NicolasVMen/app_tcc/docs/produto/imagens_montagem/03-estrutura-3d-conceito-explodido.png

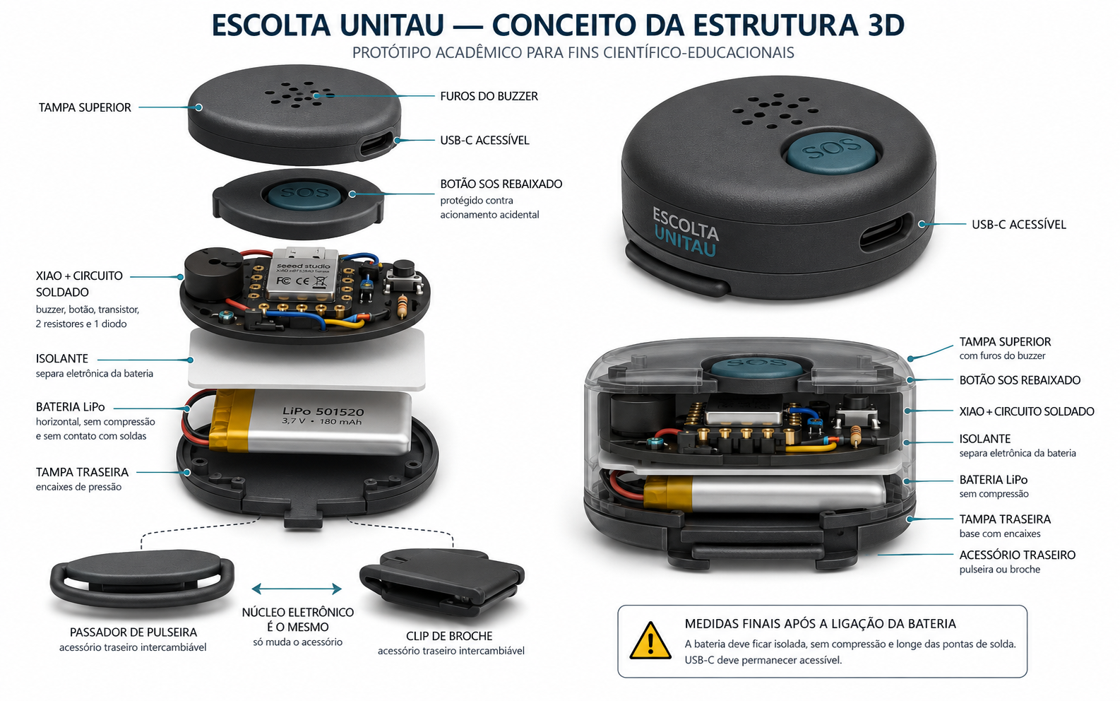
docs/produto/imagens_montagem/03-estrutura-3d-conceito-explodido.png
