NicolasVMen/app_tcc/docs/prototipo/fotos/WhatsApp Image 2026-09-24 at 19.42.54.jpeg

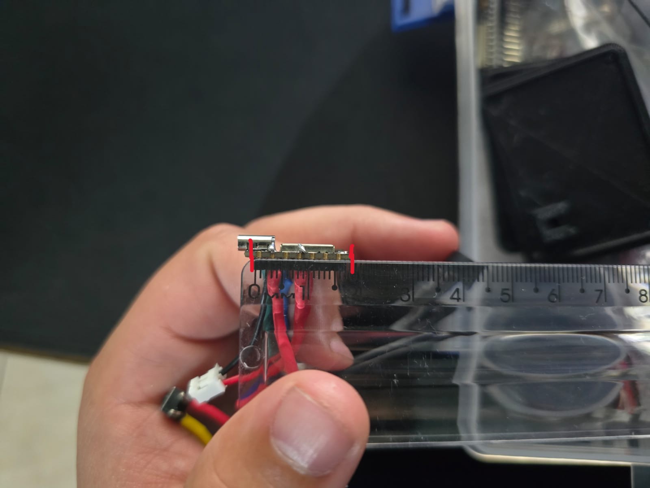
docs/prototipo/fotos/WhatsApp Image 2026-09-24 at 19.42.54.jpeg
