NicolasVMen/app_tcc/hardware/case_3d/documentacao/README_IMPRESSAO_V2_3.md

# ESCOLTA UNITAU — pacote de impressão V2.3

Revisão dimensional de 17/09/2026. Todas as fixações internas foram
padronizadas para abraçadeira de nylon T18R de 100 × 2,5 mm. Não alterar a
escala dos STL.

## Arquivos do conjunto

- `escolta_base_v2_3.stl`
- `escolta_tampa_v2_2.stl`
- `escolta_botao_reforcado_v2_2.stl`
- `escolta_trava_botao_reforcada_v2_2.stl`
- `escolta_protetor_bateria_v2_3.stl`

A tampa, o botão e a trava continuam na revisão V2.2 porque já foram
fisicamente testados. A revisão V2.3 altera somente a base e acrescenta o
protetor da bateria.

## Material de fixação

Usar quatro abraçadeiras comerciais T18R de 100 × 2,5 mm: XIAO, buzzer,
conector branco e bateria. Os túneis nominais medem 3,1 × 1,5 mm para receber
a cinta de 2,5 × 1,0 mm com folga de impressão.

Na bateria, a abraçadeira deve fechar sobre o protetor impresso. As duas pernas
do protetor ficam ao lado da bolsa e apoiadas no piso da caixa. Apertar somente
até retirar a folga; nunca esmagar ou dobrar a célula LiPo.

## Impressão

- Base e tampa: PLA ou PETG, bico 0,4 mm, camada 0,20 mm, três paredes e 20%
  de preenchimento.
- Protetor da bateria: PLA ou PETG, camada 0,20 mm, três paredes e 30% de
  preenchimento. A face larga já está orientada para a mesa.
- Botão e trava: PETG recomendado, camada 0,12 mm, quatro paredes e 100% de
  preenchimento.

As cinco malhas foram verificadas sem triângulos degenerados ou arestas
inválidas; cada arquivo possui um único corpo conectado e malha fechada.
