NicolasVMen/app_tcc/docs/cicted/banner/impressao/LEIA_ANTES_DE_IMPRIMIR.md

# Banner Escolta — arquivo para impressão

Enviar à gráfica: **Banner_Escolta_CICTED_EQUILIBRADO.pdf**.

Esta é a cópia mais recente, com legendas de fonte simplificadas para “acervo próprio” e “elaboração própria”. O conjunto das duas colunas foi deslocado 2,04 cm para cima, sem modificar o cabeçalho ou a identificação. Medindo os limites reais dos textos, o respiro entre identificação e conteúdo e entre conteúdo e borda inferior ficou em aproximadamente 5,18 cm nos dois lados. Foi preservado o alinhamento da fonte da Figura 3 com o fim das referências. As duas colunas têm a mesma largura e margens externas iguais; tabela e diagrama compartilham as bordas da coluna esquerda. O PDF foi gravado em estrutura clássica PDF 1.4, sem a árvore de marcação do Office, e sua página foi renderizada com sucesso em PDFium e PDF.js. A causa da visualização em branco no leitor do usuário não foi reproduzida; a nova estrutura é uma medida de compatibilidade, não uma causa confirmada.

- Tamanho nominal: **90 × 120 cm**, vertical, uma página.
- Imprimir a 100%, sem “ajustar à página”, sem converter o PDF em JPEG e sem otimização/compressão adicional.
- O PDF tem todas as fontes incorporadas. Os textos do trabalho continuam vetoriais.
- O **Banner_Escolta_CICTED_EQUILIBRADO.pptx** é uma cópia editável; não substitui o PDF final para a gráfica. Uma exportação comum do PowerPoint pode voltar a reduzir as imagens CAD.
- A **Banner_Escolta_CICTED_EQUILIBRADO_PREVIA.png** serve apenas para conferir o layout, não para impressão.
- Confirmar com a gráfica o perfil de cor adequado ao equipamento/material. Não aplicar conversão genérica de cor sem esse perfil.

## Melhorias e verificações

- Letras da tabela ampliadas de 22 para 24–26 pt; legendas/fontes/referências ampliadas para pelo menos 24 pt, com contraste mais escuro.
- Conferência das caixas de texto no PowerPoint: nenhum texto excedendo a altura disponível.
- Vistas CAD geradas novamente a partir do projeto local: 4.000 × 3.000 pixels por imagem, aproximadamente 1.010 ppi na dimensão diagramada.
- Cabeçalho vetorizado a partir do raster do template. As duas legendas pequenas dos logotipos foram recompostas como texto, mantendo suas palavras. A vetorização não recupera os contornos de um original vetorial oficial inexistente nesta pasta.
- Recursos integrais reinseridos no PDF após a exportação: PNG sem perdas; JPEG com seus bytes originais, sem nova recodificação. Posições e dimensões preservadas.
- A verificação automatizada compara as imagens do PDF com as do PPTX e confirma a preservação exata dos pixels/bytes.
- Versões anteriores preservadas.

## Limites reais das imagens disponíveis

As três capturas do aplicativo têm 816–821 × 1.599–1.600 pixels: aproximadamente **182–183 ppi** no tamanho diagramado. As fotografias presentes na versão anterior têm aproximadamente **242–261 ppi**. Esses recursos foram preservados na resolução integral, sem nova edição generativa nesta revisão.

Aumentar artificialmente a quantidade de pixels não recupera detalhes verdadeiros. Para elevar a definição efetiva dessas capturas/fotografias, são necessários novos arquivos originais de maior resolução e sem compressão de mensageiros. Além disso, letras pequenas dentro das telas do aplicativo continuam pequenas fisicamente no banner; resolução, por si só, não resolve esse limite de leitura.

Antes de autorizar a tiragem, vale pedir à gráfica uma prova em escala 1:1 de um trecho de texto e de uma captura do app. Isso verifica o efeito do material, tinta, equipamento e iluminação, que não pode ser certificado somente pelo arquivo digital.
