NicolasVMen/app_tcc/docs/cicted/banner/Banner_Escolta_UNITAU_CICTED_2026_CONSIDERACOES_REVISADAS.pptx

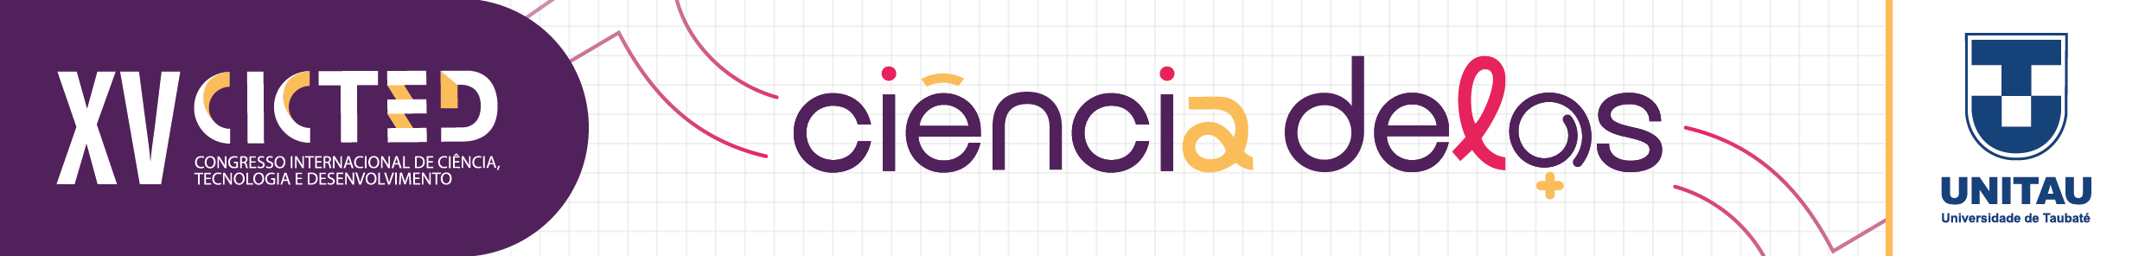
[picture p3: figure]

ENIC GRADUAÇÃO — APRESENTAÇÃO EM PÔSTER

Nº DO TRABALHO: 1782760

Autores: Nicolas Venciguerra Men; Rafael Gonçalves Dedini

Orientador: Prof. Dr. Luis Fernando de Almeida

Figura 1 — estados do aplicativo durante o afastamento

ESCOLTA UNITAU: PROTÓTIPO VESTÍVEL PARA MONITORAMENTO DE PROXIMIDADE INFANTIL POR BLUETOOTH LOW ENERGY

Introdução

Em locais movimentados, o afastamento de uma criança pode não ser percebido de imediato. O Escolta UNITAU integra dispositivo vestível e aplicativo Android para acompanhar condições de proximidade por BLE, sinalizar degradação ou perda do enlace e oferecer um botão físico de emergência. Objetivo: avaliar essa prova de conceito integrada.

Protegido

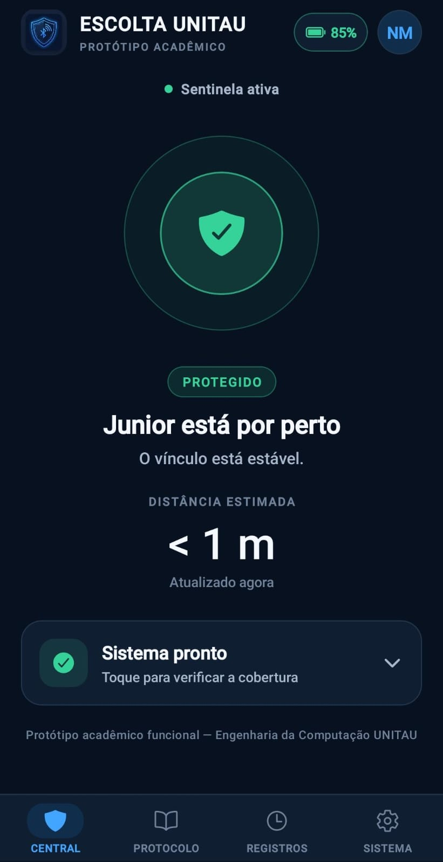
[picture p4: figure]

Alcance Reduzido

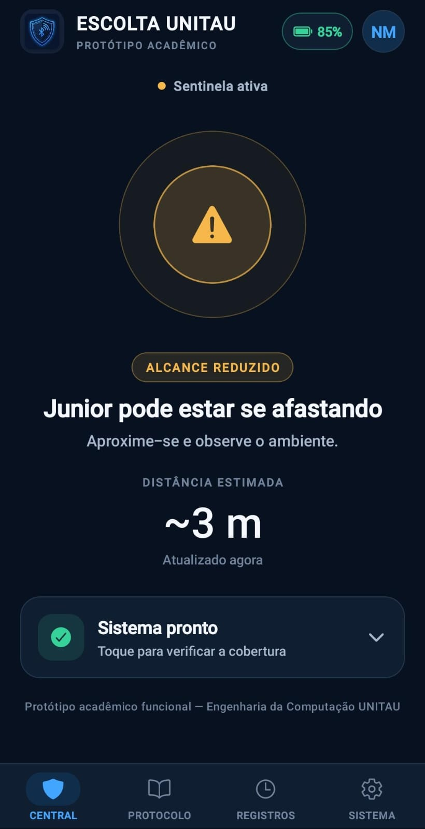
[picture p5: figure]

Emergência

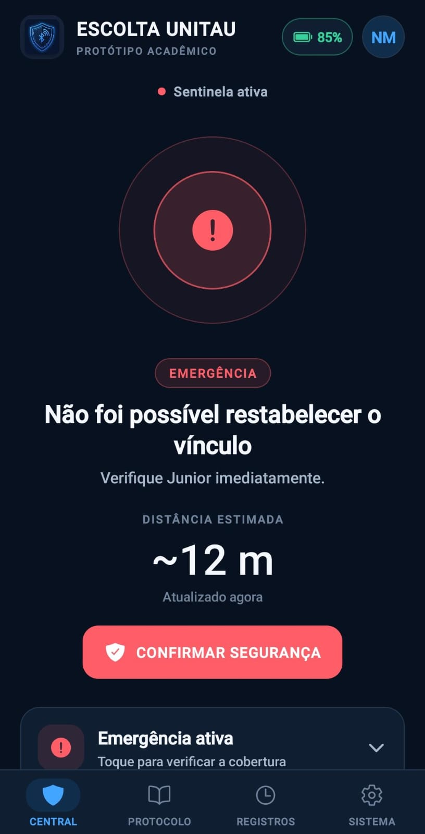
[picture p6: figure]

Método

Pesquisa aplicada e experimental. Vestível com XIAO nRF52840 Sense, firmware C++/Arduino, buzzer, botão e LiPo 180 mAh; app Android em React Native/Expo com serviço em primeiro plano. RSSI usado como indicador experimental de proximidade. Ensaios iterativos iniciais em Samsung Galaxy S24 Ultra.

Resultados

Fonte: capturas reais dos autores (2026). Metros exibidos: estimativas por RSSI.

Figura 2 — projeto CAD e protótipo físico

OpenSCAD · perspectiva

OpenSCAD · vista superior

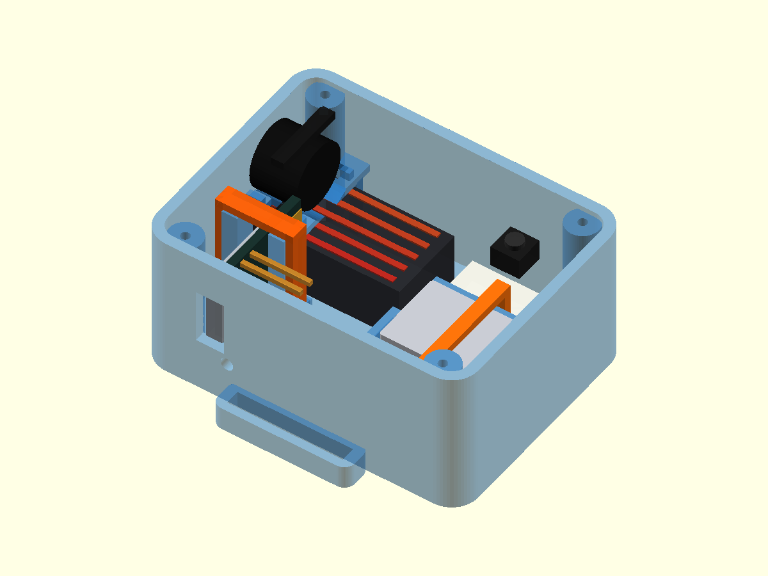
[picture p7: figure]

Caixa aberta

Caixa fechada

CENÁRIO

Vínculo BLE

COMO FOI VERIFICADO

Conexão, perda do enlace e tentativas de reconexão.

RESULTADO OBSERVADO

A perda acionou alerta no telefone; o sistema tentou reconectar.

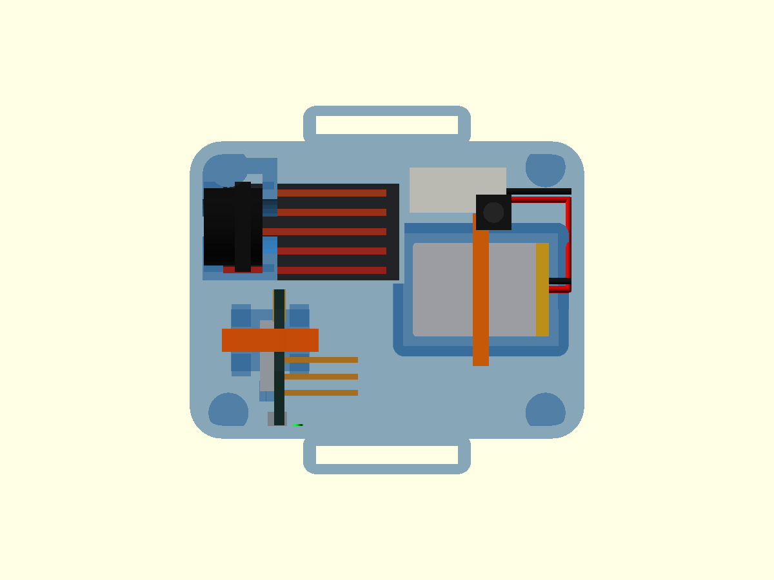
[picture p8: figure]
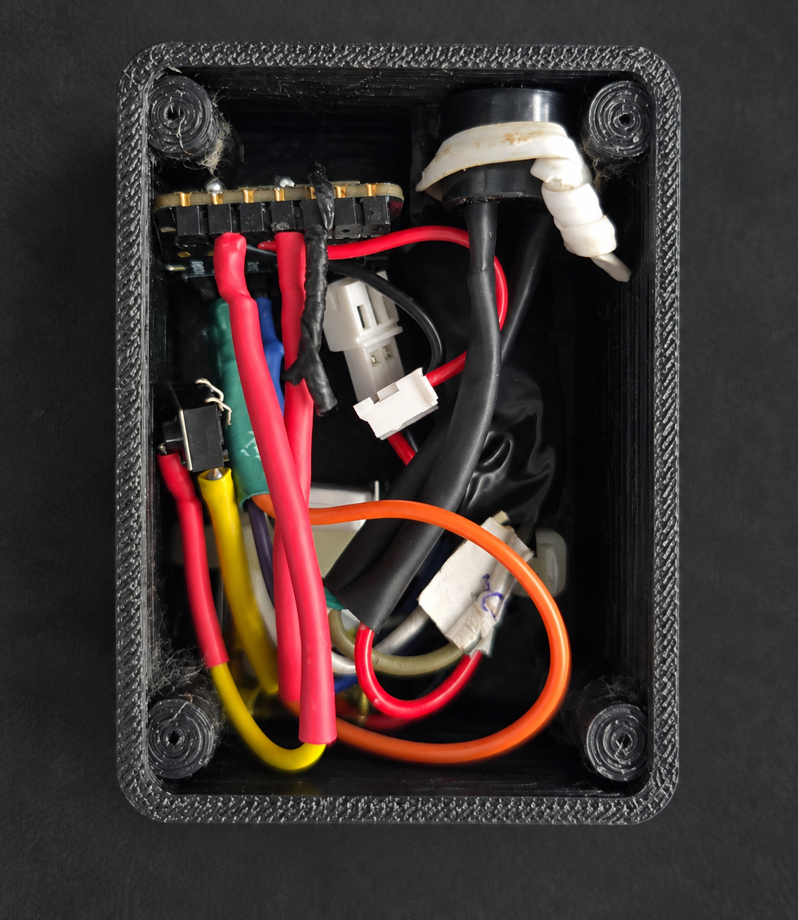
[picture p9: figure]
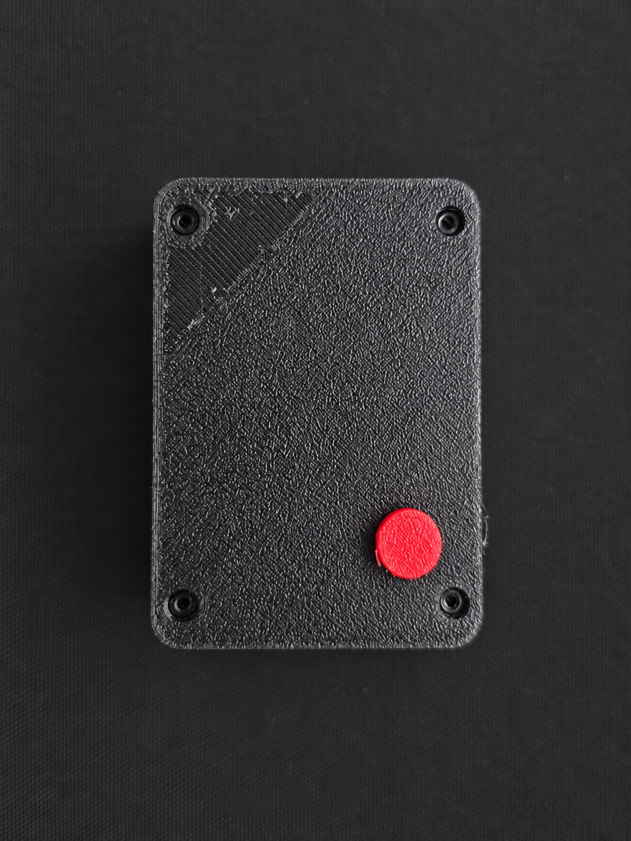
[picture p10: figure]

Segundo plano

Botão físico

Aplicativo

Tela bloqueada e serviço Android em primeiro plano.

Acionamento de emergência no vestível conectado.

Navegação, estados, registros e confirmação de segurança.

Após correções do serviço, a monitoração persistiu.

Resposta sonora no dispositivo e no telefone.

Estados protegido, alcance reduzido e emergência registrados.

Fonte: modelo CAD e fotografias dos autores (2026).

Considerações finais

A integração entre o vestível e o aplicativo demonstrou viabilidade técnica nas condições ensaiadas. Após as correções no serviço Android, a monitoração persistiu no Galaxy S24 Ultra, modelo usado na validação inicial. A perda do enlace BLE acionou o alerta de desconexão, enquanto o botão físico permitiu disparar o alerta manual.
Em um ciclo de monitoração contínua, a placa operou por 11 h 10 entre 90% e 5% de carga estimada, com as saídas automáticas de alerta bloqueadas. Trata-se de um resultado preliminar: o tempo de uso pode mudar com reconexões, acionamentos sonoros e outras condições de operação.
O RSSI permitiu observar mudanças na intensidade do sinal, mas variou com obstáculos, orientação e ambiente. Por isso, os valores indicados pelo aplicativo não devem ser interpretados como medição precisa de distância. Os testes confirmam o funcionamento integrado do protótipo, mas ainda não permitem generalizar o desempenho para diferentes celulares e cenários de uso.

Síntese dos cenários documentados para o conjunto vestível + aplicativo.

Gráfico 1 — autonomia preliminar

100%

Carga estimada da bateria (%)

90%

4,09 V

75%

50%

25%

0%

INÍCIO

BATERIA BAIXA

10%

3,58 V

FIM DO ENSAIO

5%

3,54 V

Referências

BLUETOOTH SIG. The Bluetooth Low Energy Primer. 2022.
FARAGHER, R.; HARLE, R. Location Fingerprinting With Bluetooth Low Energy Beacons. IEEE JSAC, 33(11), 2015.
SAKPHROM, S. et al. A Simplified and High Accuracy Algorithm of RSSI-Based Localization Zoning for Children Tracking In-Out the School Buses Using Bluetooth Low Energy Beacon. Informatics, 8(4):65, 2021.

LiPo 180 mAh · um ciclo · monitoramento BLE contínuo · saídas automáticas de alerta bloqueadas.

Fonte: ensaio de bateria dos autores, 08–09/09/2026.

0 h

10 h 05

11 h 10
