NicolasVMen/app_tcc/docs/README.md

# Documentação

- `cicted/`: arquivos identificados, anônimos, revisões e versão final do evento.
- `produto/`: especificação funcional, fluxos e diagramas de montagem.
- `prototipo/`: fotografias originais usadas nas medições do hardware.
- `tcc/`: capítulos, projeto de pesquisa e modelos acadêmicos.
- `testes/`: relatórios de celular, autonomia e demais ensaios.
- `auditoria/`: mapa da arquitetura, catálogo por arquivo, evidências e pendências.

Fechamento acadêmico: [plano e critérios de atualização de 04/11/2026](tcc/FECHAMENTO_TCC_2026-11-04.md).
Próximo ensaio: [protocolo de autonomia com registro proposto](testes/PROTOCOLO_AUTONOMIA_USO_2026-11-04.md).
Distribuição: [oficial Android 1.0.1, aceite de 17/10 e atualização do botão em 04/11](auditoria/PREPARACAO_OFICIAL_VALIDADA_2026-10-17.md).
Referência histórica: [auditoria de 07/10/2026](auditoria/RELATORIO_2026-10-07.md).
Implementações posteriores: [correções de 09/10/2026](auditoria/CORRECOES_2026-10-09.md).
CICTED e TCC são entregas diferentes; manter seus documentos separados.

Arquivos intermediários permanecem em suas respectivas subpastas para manter
o histórico acadêmico separado do código do aplicativo.

Capturas do console autenticado, credenciais, dependências locais e backups
permanecem somente no computador; não integram o versionamento público.
