NicolasVMen/app_tcc/docs/tcc/README.md

# Texto acadêmico — Escolta UNITAU

## Revisão atual de 04/11/2026

- `TCC_Escolta_UNITAU_ATUALIZADO_2026-11-04.docx`: cópia editável, com desenvolvimento,
  resultados e conclusão preenchidos e atualização técnica dos capítulos iniciais.
- `TCC_Escolta_UNITAU_ATUALIZADO_2026-11-04.pdf`: exportação do mesmo Word, 41 páginas.
- `FECHAMENTO_TCC_2026-11-04.md`: critérios de evidência, pendências e confirmação
  de envio ao Drive, incluindo links e hashes locais.
- `REVISAO_2026-11-04_CAPITULOS_4_A_6.md`: fonte textual dos capítulos acrescentados.
- `VERIFICACAO_REVISAO_2026-11-04.json`: integridade do original e dados do gráfico.
- `VERIFICACAO_PDF_2026-11-04.json`: conferência estrutural/textual das páginas.

A revisão é fiel às fontes de implementação e aos resultados identificados,
mas **ainda precisa de revisão dos autores e do orientador**. Não é declaração
de homologação, patenteabilidade ou conformidade normativa integral.
Autonomia atual e bateria baixa real permanecem sem novo ensaio. A proposta
de coletor não foi implementada e não é apresentada como resultado obtido.

Word no Drive: https://docs.google.com/document/d/1DhnyRvAgA25Ioz3kZwKFdNv8MnQj-EA_/edit

PDF no Drive: https://drive.google.com/file/d/1Dv2qfMFWDSk-kZCphoBeKt73M8d9ED3b/view

## Histórico e preservação

Arquivos `TG_Escolta_UNITAU_ate_Capitulo_4.*`, capítulo introdutório,
projeto de pesquisa e template são fontes históricas; não representam a
revisão atual. Permanecem preservados. A cópia original do Word do Drive
foi salva em `backups/tcc/2026-11-04/` e também duplicada na pasta do Drive
antes da atualização, sem alterar os arquivos do 9º semestre.

Ferramentas locais de reprodução: `tools/atualizar_tcc_2026_11_04.py`,
`tools/renderizar_tcc_word_2026_11_04.ps1` e `tools/conferir_pdf_tcc_2026_11_04.mjs`.
O gerador depende da fonte original identificada; não o executar sobre uma
revisão manual posterior sem antes comparar as alterações. O script Word
gera artefatos; não envia arquivos ao Drive ou GitHub automaticamente.
