NicolasVMen/app_tcc/docs/cicted/PENDENCIAS_PARA_SUBMISSAO.md

# Situação da submissão ao XV CICTED 2026

O resumo foi revisado pelo orientador e preparado nas versões identificada e não identificada exigidas pela plataforma Even3.

Antes de gerar a versão final, confirmar:

- [x] orientador: Luis Fernando de Almeida;
- [x] e-mail de Rafael: `rafael.gdedini@unitau.br`;
- [x] e-mail do orientador: `luis.almeida@unitau.br`;
- [x] e-mail institucional de Nicolas: `nicolas.vmen@unitau.br`;
- [x] orientador incluído como coautor;
- [x] categoria: `ENIC Graduação — Apresentação em Pôster — Resumo`;
- [x] área temática: `EXATAS`;
- [x] ODS 3 – Saúde e Bem-Estar;
- [x] ODS 9 – Indústria, Inovação e Infraestrutura;
- [x] declaração de uso supervisionado de IA generativa incluída no resumo;
- [x] revisão do orientador recebida e incorporada;
- [x] ORCID de Nicolas conectado à Even3;
- [x] arquivo identificado gerado;
- [x] arquivo não identificado e sem metadados pessoais gerado;
- [ ] concluir e confirmar a submissão na Even3;
- [ ] após a aprovação, obter o modelo e as dimensões oficiais do pôster de 2026;
- [ ] preparar o pôster e a apresentação curta do protótipo.

Prazo informado no material fornecido: **14 de setembro de 2026**.

A versão de submissão deve permanecer em formato editável `.docx`, sem citações, notas de rodapé, tabelas, figuras ou referências bibliográficas.
