NicolasVMen/app_tcc/CICTED/Banner_Escolta_CICTED_EQUILIBRADO.pptx

ENIC GRADUAÇÃO — APRESENTAÇÃO EM PÔSTER

Nº DO TRABALHO: 1782760

Autores: Nicolas Venciguerra Men; Rafael Gonçalves Dedini

Orientador: Prof. Dr. Luis Fernando de Almeida

Figura 1 — estados do aplicativo durante o afastamento

ESCOLTA UNITAU: PROTÓTIPO VESTÍVEL PARA MONITORAMENTO DE PROXIMIDADE INFANTIL POR BLUETOOTH LOW ENERGY

Introdução

Protegido


Alcance Reduzido


Emergência


Em locais movimentados, o afastamento de uma criança pode não ser percebido de imediato. (Colocar citação, estatísticas, se tiver) O Escolta UNITAU integra dispositivo vestível e aplicativo Android para acompanhar condições de proximidade por Bluetooth Low Energy (BLE) – Termo em inglês em itálico, sinalizar degradação ou perda do enlace e oferecer um botão físico de emergência.
Colocar objetivo do trabalho, antes do escolta Unitau, objetivo antes do “produto”
Trocar de posição figura 1 com a figura 3, para fazer sentido, figura 3(Resultado), figura 1 (Arquitetura)

Método

Trata-se de uma pesquisa aplicada e experimental. Vestível com XIAO nRF52840 Sense, firmware C++/Arduino, buzzer, botão e LiPo 180 mAh; app Android em React Native/Expo com serviço em primeiro plano. RSSI usado como indicador experimental de proximidade. Ensaios iterativos preliminares em Samsung Galaxy S24 Ultra.
Como foi o processo para desenvolvimento desse trabalho? Ficou mais parecido como resultado do que com o processo para chegar no resultado, colocar busca de harware, pesquisas, porque cada dispositivo foi escolhida, metodologia

Resultados

Fonte: acervo próprio (2026). Metros exibidos: estimativas por RSSI.

Figura 2 — projeto CAD e protótipo físico

OpenSCAD · perspectiva

OpenSCAD · vista superior


Caixa aberta


Caixa fechada


CENÁRIO

Vínculo BLE

Segundo plano

COMO FOI VERIFICADO

Conexão, perda do enlace e tentativas de reconexão.

Tela bloqueada e serviço Android em primeiro plano.

RESULTADO OBSERVADO

A perda acionou alerta no telefone; o sistema tentou reconectar.

Após correções do serviço, a monitoração persistiu.


Botão físico

Aplicativo

Acionamento de emergência no vestível conectado.

Navegação, estados, registros e confirmação de segurança.

Resposta sonora no dispositivo e no telefone.

Estados protegido, alcance reduzido e emergência registrados.

Fonte: elaboração própria e acervo próprio (2026).

Fonte: elaboração própria (2026).
Autonomia preliminar: 11 h 10, de 90% a 5% estimados (um ciclo, sem alertas automáticos).
Adicionar uma linha com cenário, colocando autonomia preliminar

Figura 3 — arquitetura funcional e resposta aos eventos

VESTÍVEL

XIAO nRF52840 Sense
Botão, buzzer e bateria

APLICATIVO ANDROID

Serviço persistente
RSSI filtrado e estados

Considerações finais

A integração entre o vestível e o aplicativo demonstrou viabilidade técnica nas condições ensaiadas. Após as correções no serviço Android, a monitoração persistiu no Galaxy S24 Ultra, modelo usado na validação. A perda do enlace BLE acionou o alerta de desconexão, enquanto o botão físico permitiu disparar o alerta manual.
Em um ciclo de monitoração contínua, a placa operou por aproximadamente 11h entre 90% e 5% de carga estimada, com as saídas automáticas de alerta bloqueadas. Trata-se de um resultado preliminar: o tempo de uso pode mudar com reconexões, acionamentos sonoros e outras condições de operação.
O RSSI, que significa distancia entre celular e dispositivo permitiu observar mudanças na intensidade do sinal, mas variou com obstáculos, orientação e ambiente. Por isso, os valores indicados pelo aplicativo não devem ser interpretados como medição precisa de distância. Os testes confirmam o funcionamento integrado do protótipo, mas ainda não permitem generalizar o desempenho para diferentes celulares e cenários de uso.
Deixar mais fácil entendimento o banner, explicar termos técnicos.

Referências

BLUETOOTH SIG. The Bluetooth Low Energy Primer. 2022.
FARAGHER, R.; HARLE, R. Location Fingerprinting With Bluetooth Low Energy Beacons. IEEE JSAC, 33(11), 2015.
SAKPHROM, S. et al. A Simplified and High Accuracy Algorithm of RSSI-Based Localization Zoning for Children Tracking In-Out the School Buses Using Bluetooth Low Energy Beacon. Informatics, 8(4):65, 2021.
Especificar onde está citado assunto do trabalho exatamente, igual TCC, caso não tenha, pode apagar, se tiver apenas uma referência é válido

Caminhos de resposta

Indicação de alcance reduzido no aplicativo.

SINAL ENFRAQUECE

→

↔
BLE

Tentativa de reconexão; alerta se não recuperar.

ENLACE SE PERDE

Com vínculo ativo, alerta manual nos dois lados.

Fonte: Os autores (2026). – “Os autores ou elaboração própria?” Verificar

BOTÃO FÍSICO

→

→
