NicolasVMen/app_tcc/docs/cicted/Resumo_Escolta_UNITAU_XV_CICTED_2026_FINAL.docx

ESCOLTA UNITAU: PROTÓTIPO VESTÍVEL PARA MONITORAMENTO DE PROXIMIDADE INFANTIL POR BLUETOOTH LOW ENERGY

Objetivo(s) de Desenvolvimento Sustentável (ODS): ODS 3 – Saúde e Bem-Estar; ODS 9 – Indústria, Inovação e Infraestrutura

Nicolas Venciguerra Men¹; Rafael Gonçalves Dedini²; Luis Fernando de Almeida³

¹Universidade de Taubaté – Taubaté/SP – Brasil – nicolas.vmen@unitau.br; ²Universidade de Taubaté – Taubaté/SP – Brasil – rafael.gdedini@unitau.br; ³Universidade de Taubaté – Taubaté/SP – Brasil – luis.almeida@unitau.br.

Resumo

A segurança infantil em ambientes com grande circulação de pessoas demanda recursos capazes de auxiliar responsáveis na percepção rápida de afastamentos, sem substituir a supervisão humana. Este trabalho apresenta o desenvolvimento do Escolta UNITAU, protótipo acadêmico funcional composto por um dispositivo vestível e um aplicativo móvel para monitoramento de proximidade por Bluetooth Low Energy (BLE). O objetivo foi projetar e avaliar uma prova de conceito de baixo custo que sinalize a degradação ou perda do vínculo sem fio, realize tentativas automáticas de reconexão e acione alertas locais, além de disponibilizar um botão físico de emergência à criança. A pesquisa caracteriza-se como aplicada, experimental e de desenvolvimento tecnológico. O dispositivo foi implementado com a placa Seeed Studio XIAO nRF52840 Sense, firmware em C++ no ambiente Arduino, buzzer ativo, transistor P2N2222A, diodo de proteção, resistores e botão tátil, enquanto o aplicativo foi desenvolvido em React Native com Expo, inicialmente para Android. A intensidade do sinal recebido (RSSI) é processada para fornecer ao responsável uma estimativa experimental de distância e estados de cobertura, reconhecendo-se a influência de obstáculos, do corpo humano e do ambiente. Foram executados ensaios iterativos em um Samsung Galaxy S24 Ultra envolvendo autenticação, navegação, conexão automática, perda do vínculo, reconexão, funcionamento em segundo plano, tela bloqueada, alarmes sonoros, vibração, registros de ocorrências, preferências e confirmação de segurança. As falhas observadas nos primeiros ciclos orientaram correções no serviço Android em primeiro plano, na sincronização dos estados e no encerramento seguro dos alertas. Após os ajustes, verificou-se o funcionamento da monitoração persistente, da emergência por perda de conexão e do acionamento físico pelo botão, com resposta sonora no dispositivo e no telefone. O circuito do protótipo foi soldado e validado, permanecendo em andamento a integração da bateria, a medição de autonomia, a calibração sistemática da estimativa de distância e a fabricação da estrutura vestível por impressão 3D. Ferramentas de inteligência artificial generativa foram utilizadas de forma supervisionada no apoio à organização, programação e revisão, permanecendo as decisões e validações sob responsabilidade dos autores. Conclui-se que a arquitetura demonstrou viabilidade técnica como prova de conceito integrada, mas necessita de ensaios adicionais em diferentes aparelhos e ambientes antes de qualquer aplicação além do contexto acadêmico.

Palavras-chave: Sistemas embarcados. Aplicativo móvel. Comunicação sem fio. Alerta de afastamento. Internet das Coisas.
