NicolasVMen/app_tcc/docs/prototipo/fotos/2.jpeg

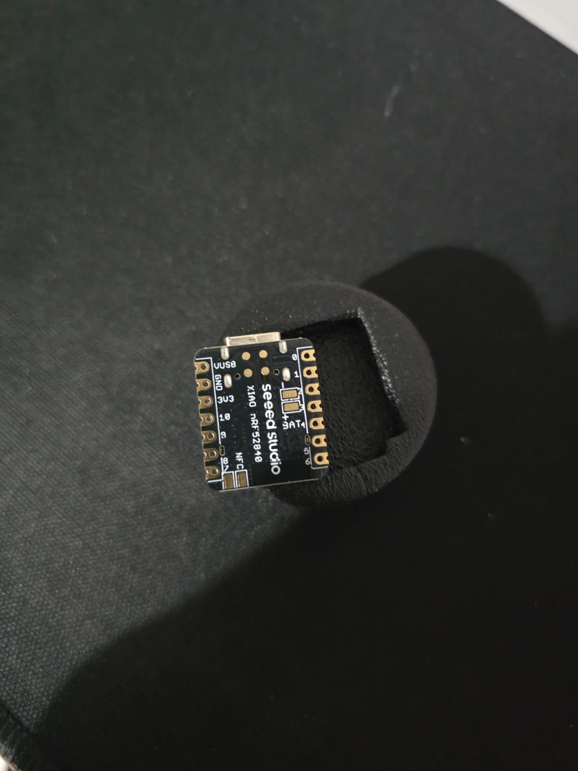
docs/prototipo/fotos/2.jpeg
