NicolasVMen/app_tcc/docs/prototipo/fotos/3.jpeg

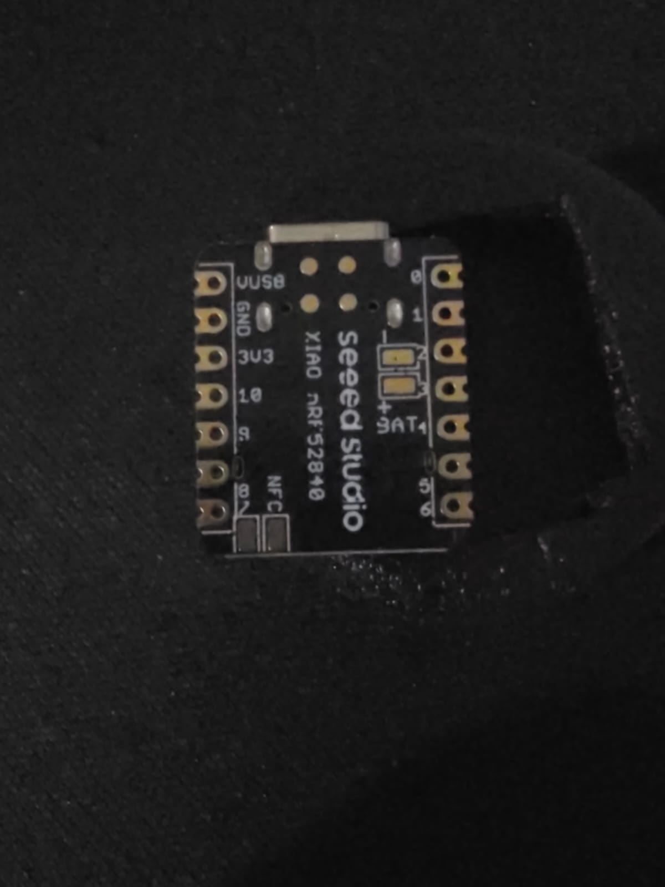
docs/prototipo/fotos/3.jpeg
