NicolasVMen/app_tcc/docs/prototipo/fotos/4.jpeg

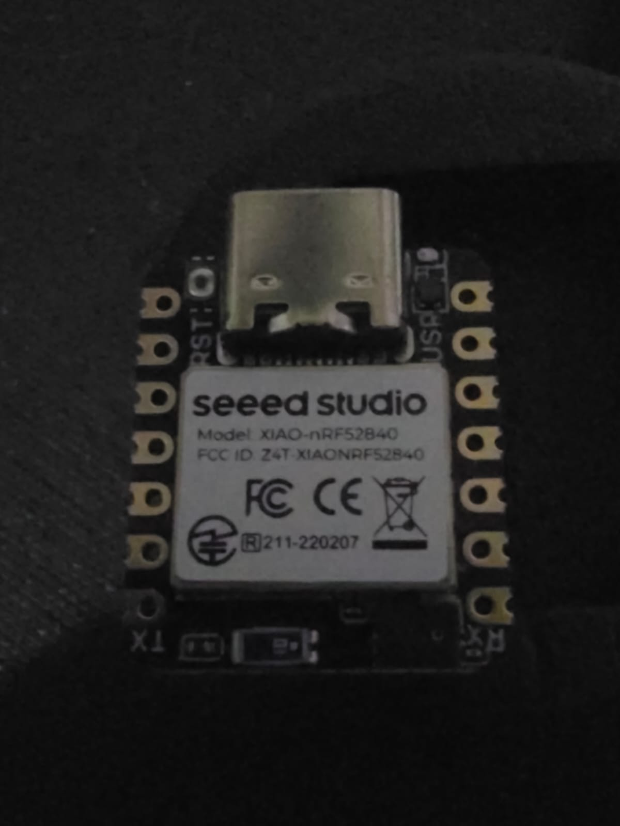
docs/prototipo/fotos/4.jpeg
