NicolasVMen/app_tcc/docs/prototipo/fotos/5.jpeg

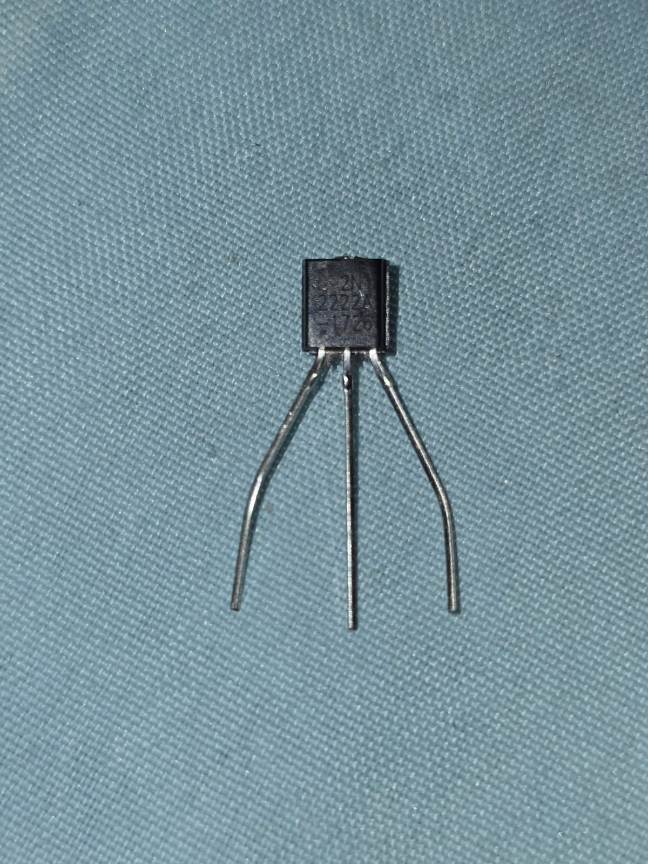
docs/prototipo/fotos/5.jpeg
