NicolasVMen/app_tcc/docs/prototipo/fotos/6.jpeg

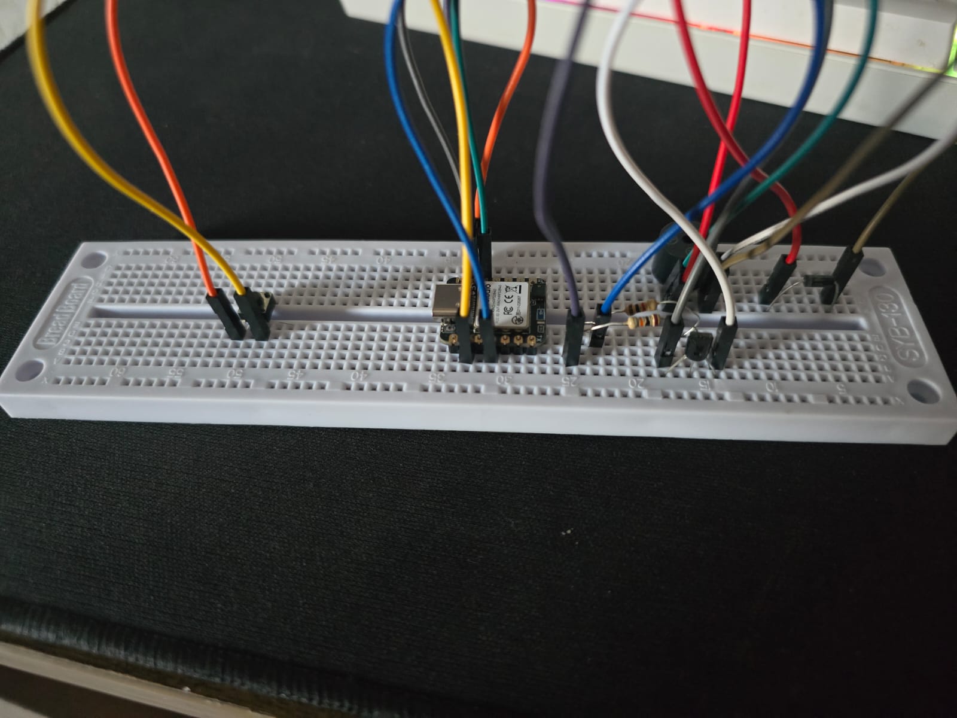
docs/prototipo/fotos/6.jpeg
