NicolasVMen/app_tcc/docs/prototipo/fotos/8.jpeg

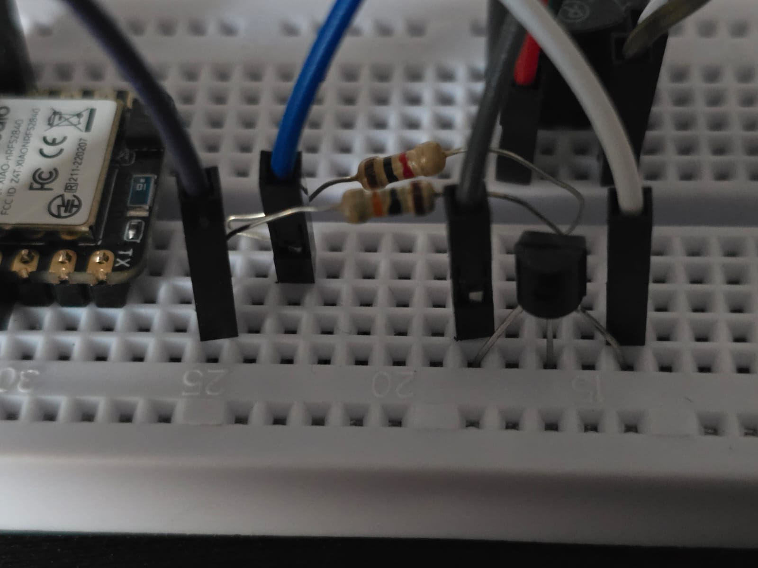
docs/prototipo/fotos/8.jpeg
