NicolasVMen/app_tcc/docs/prototipo/fotos/9.jpeg

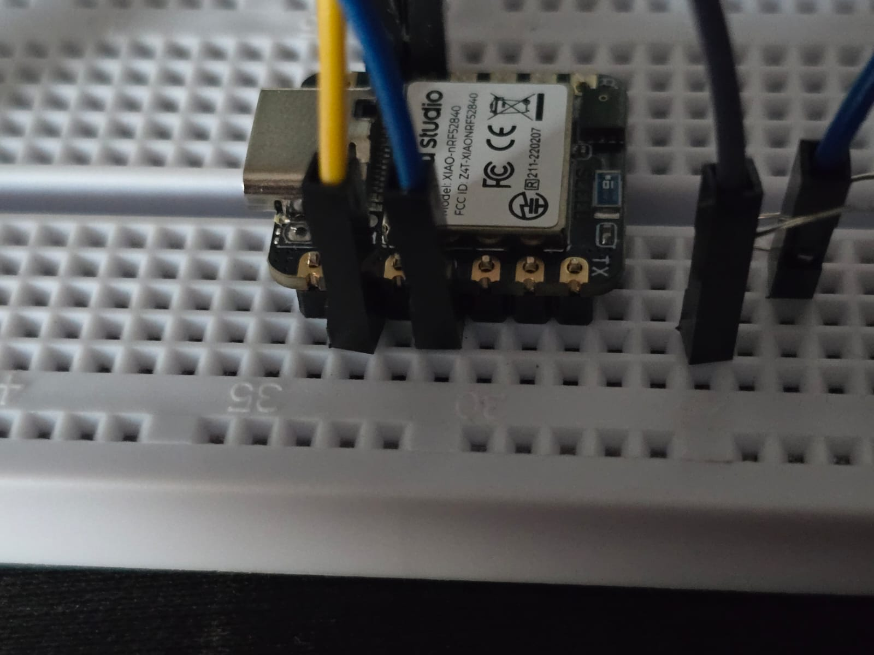
docs/prototipo/fotos/9.jpeg
