NicolasVMen/app_tcc/docs/prototipo/fotos/10.jpeg

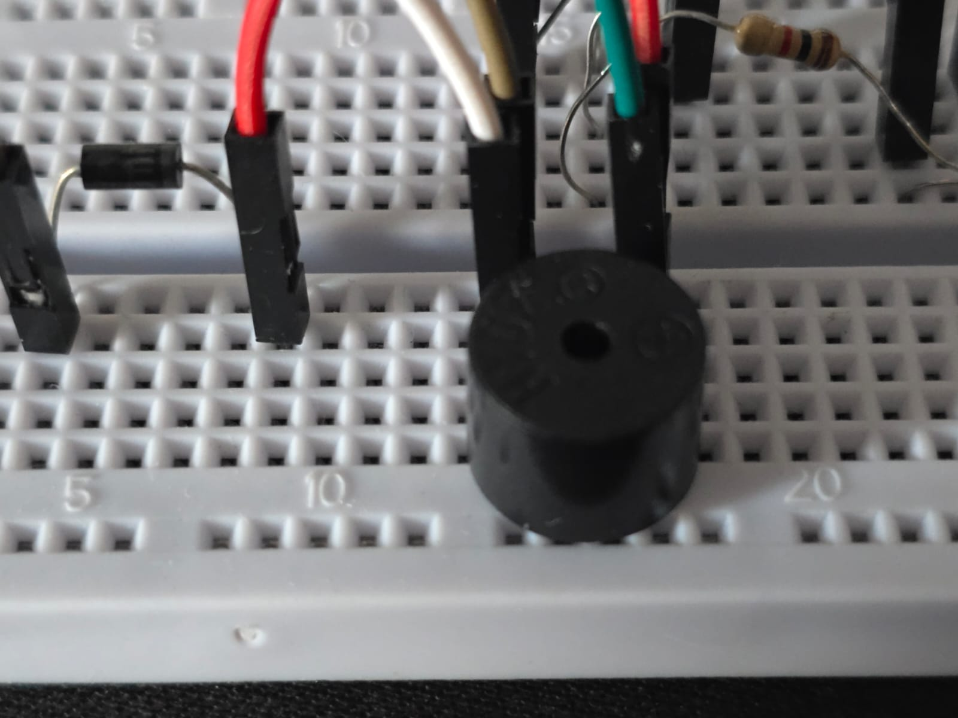
docs/prototipo/fotos/10.jpeg
