NicolasVMen/app_tcc/docs/prototipo/fotos/11.jpeg

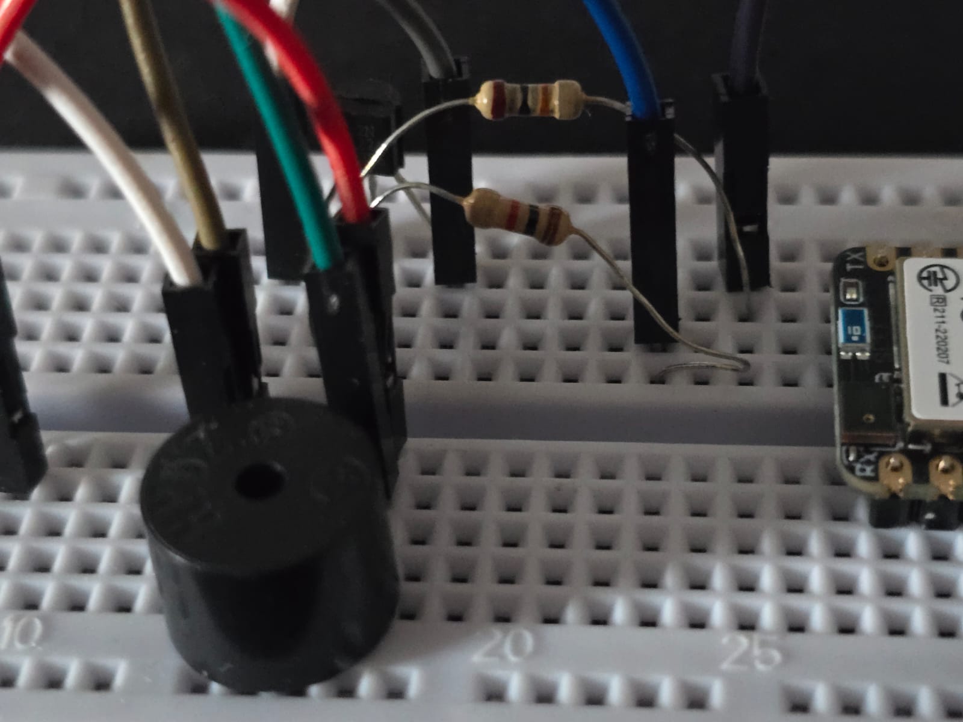
docs/prototipo/fotos/11.jpeg
