NicolasVMen/app_tcc/docs/prototipo/fotos/12.jpeg

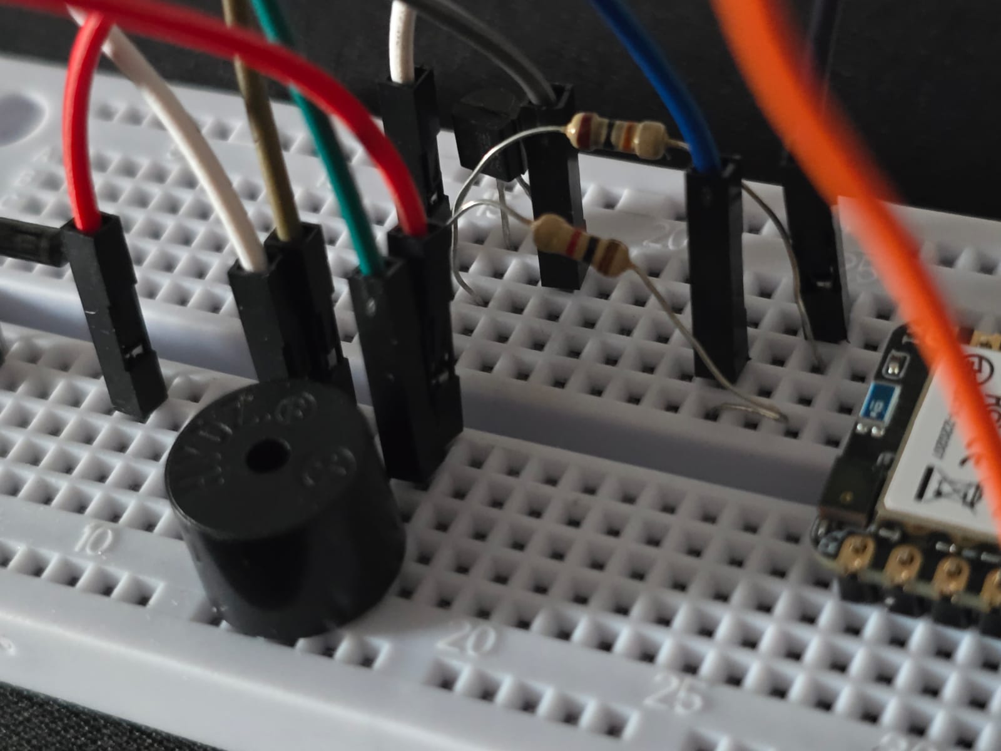
docs/prototipo/fotos/12.jpeg
