NicolasVMen/app_tcc/docs/prototipo/fotos/13.jpeg

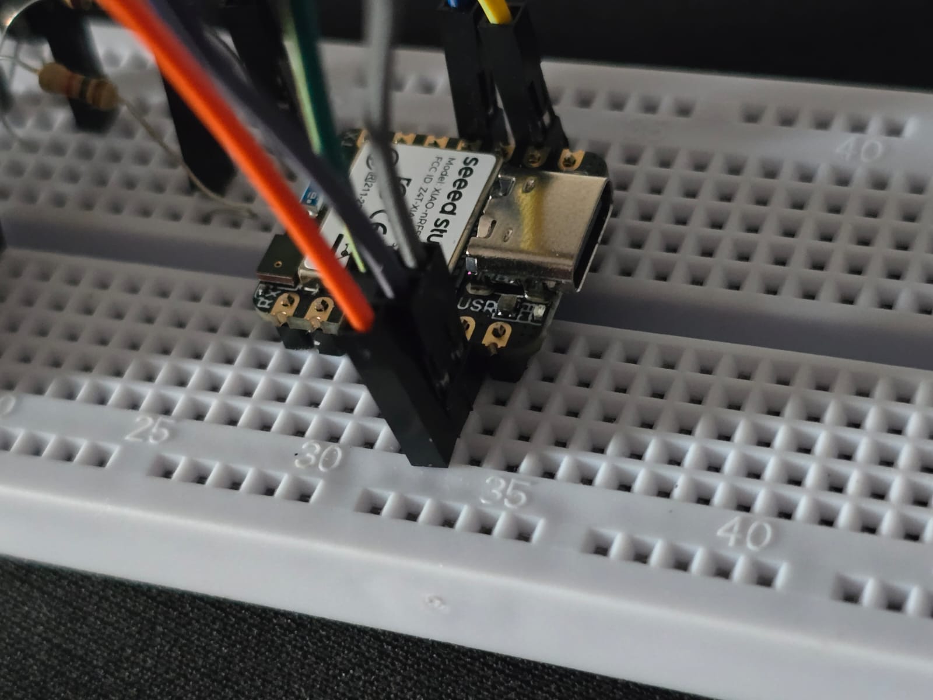
docs/prototipo/fotos/13.jpeg
