NicolasVMen/app_tcc/docs/prototipo/fotos/14.jpeg

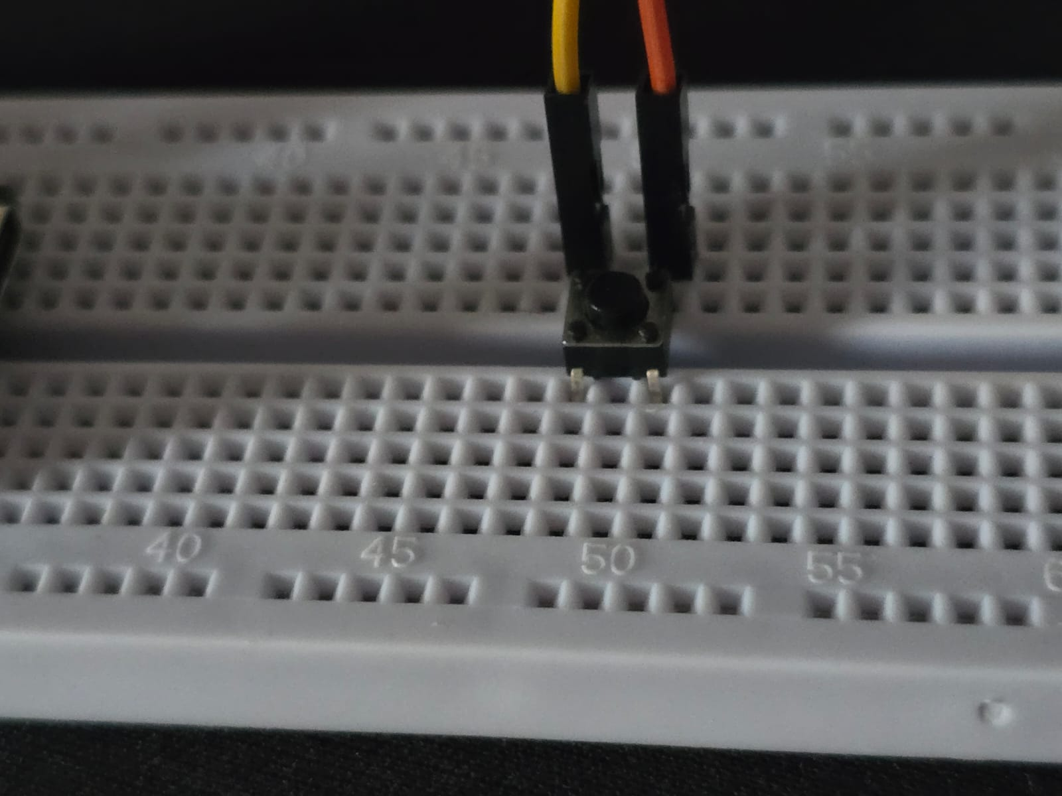
docs/prototipo/fotos/14.jpeg
