NicolasVMen/app_tcc/docs/prototipo/fotos/20.jpeg

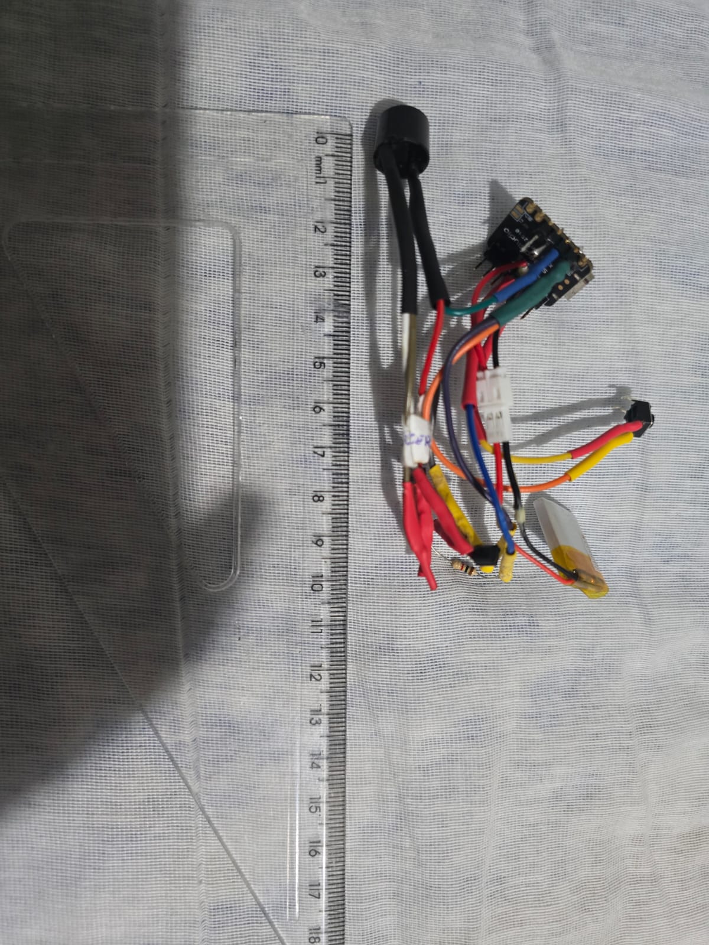
docs/prototipo/fotos/20.jpeg
