NicolasVMen/app_tcc/docs/prototipo/fotos/30.jpeg

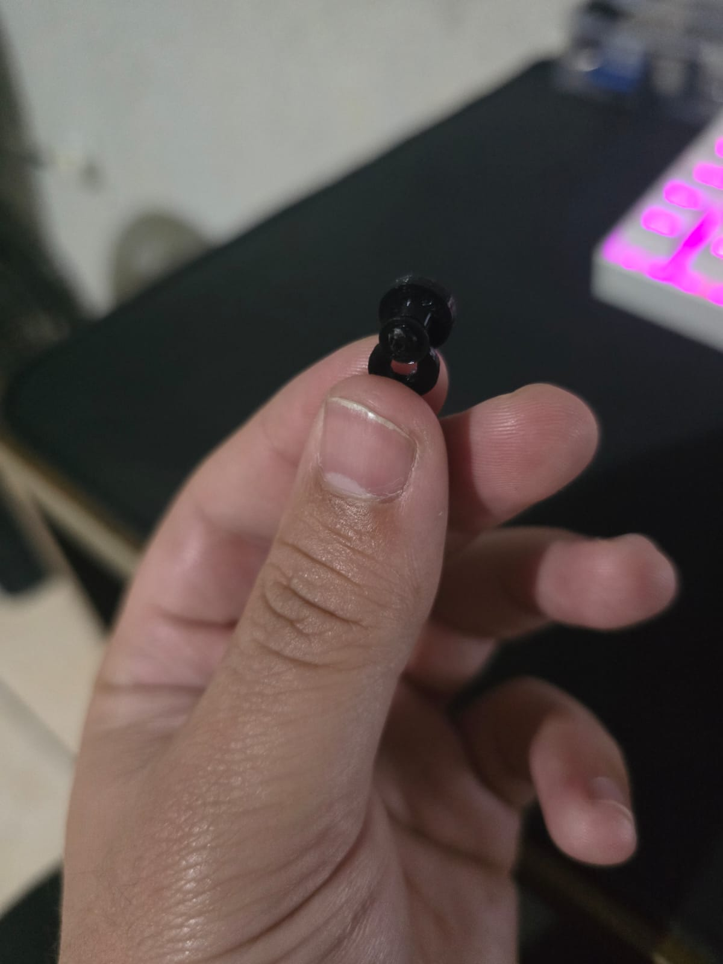
docs/prototipo/fotos/30.jpeg
