NicolasVMen/app_tcc/docs/prototipo/fotos/35.jpeg

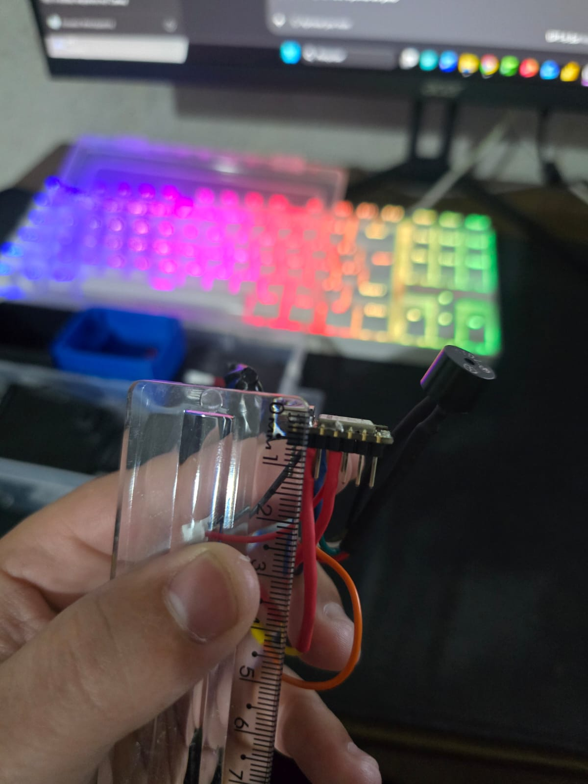
docs/prototipo/fotos/35.jpeg
