NicolasVMen/app_tcc/docs/prototipo/fotos/Imagem do Codex 8 de set. de 2026, 17_20_24.png

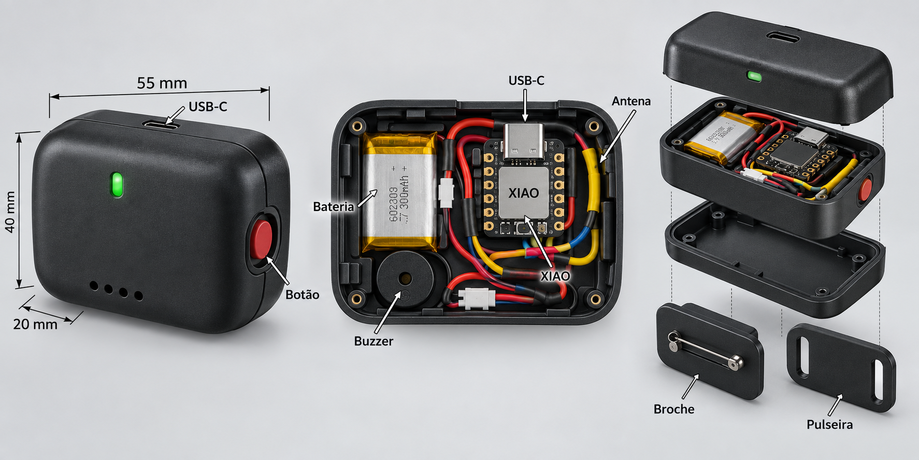
docs/prototipo/fotos/Imagem do Codex 8 de set. de 2026, 17_20_24.png
