NicolasVMen/app_tcc/docs/prototipo/fotos/Imagem do Codex 8 de set. de 2026, 18_06_47.png

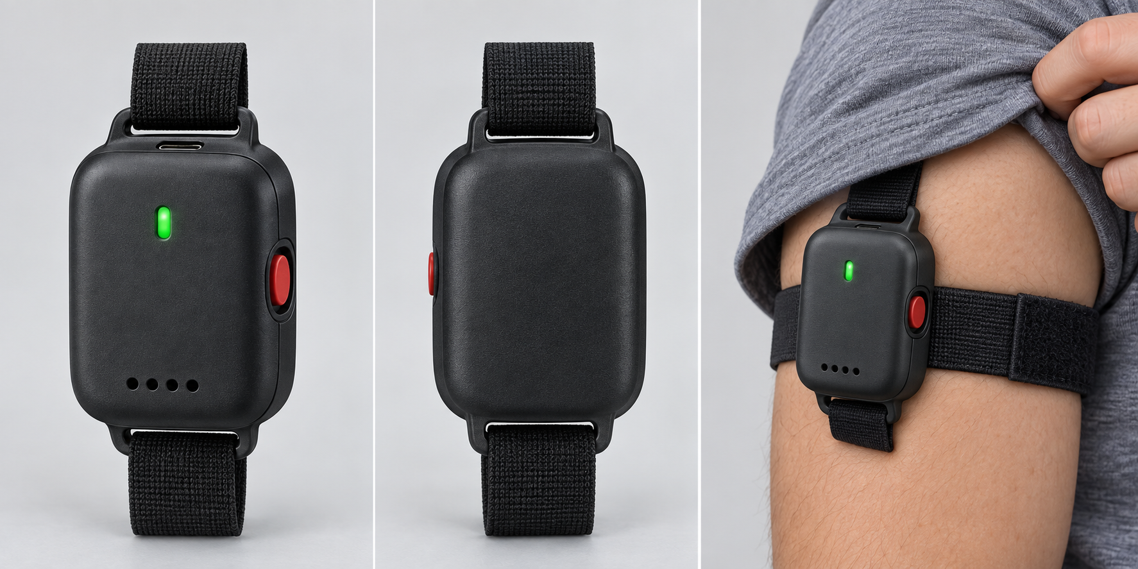
docs/prototipo/fotos/Imagem do Codex 8 de set. de 2026, 18_06_47.png
