NicolasVMen/app_tcc/docs/prototipo/fotos/Imagem do Codex 15 de set. de 2026, 18_37_50.png

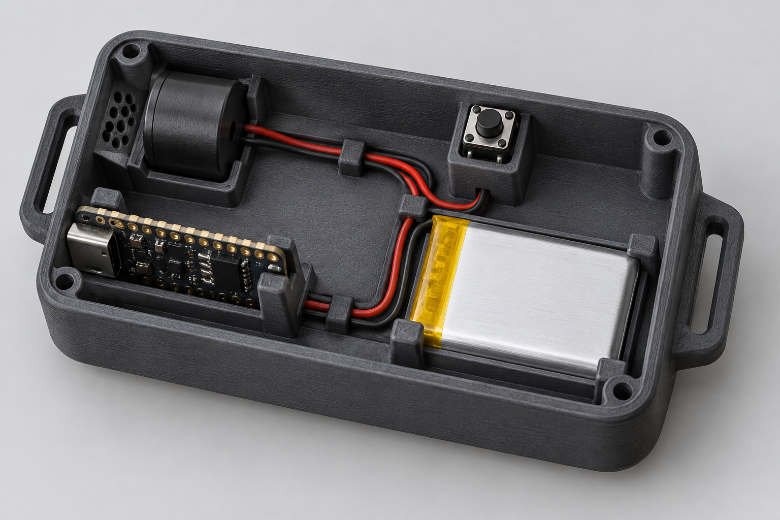
docs/prototipo/fotos/Imagem do Codex 15 de set. de 2026, 18_37_50.png
