NicolasVMen/app_tcc/docs/prototipo/fotos/placa_com_regua_3.jpeg

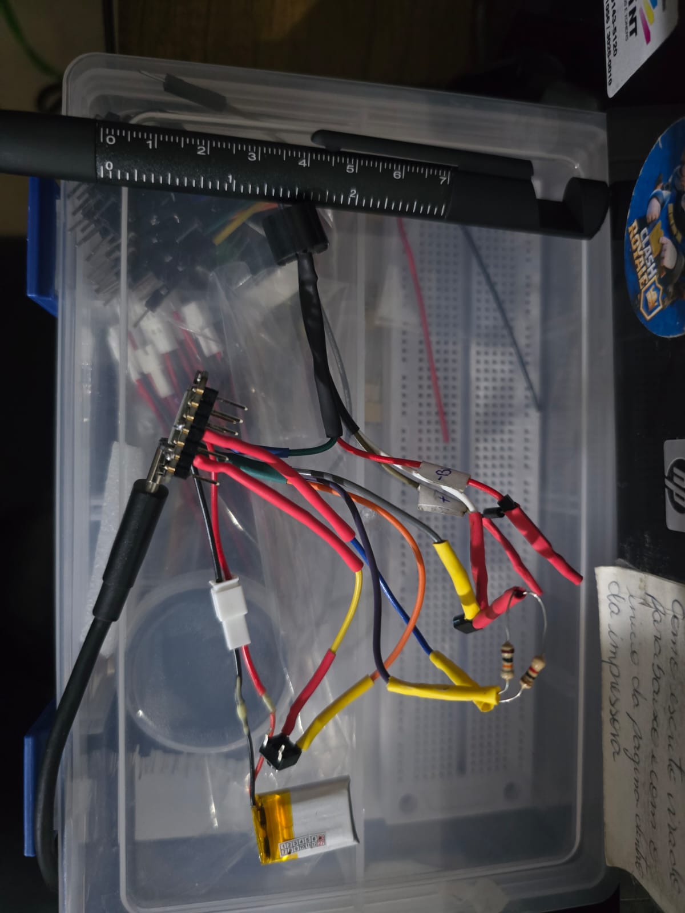
docs/prototipo/fotos/placa_com_regua_3.jpeg
