NicolasVMen/app_tcc/docs/prototipo/fotos/placa_com_regua_4.jpeg

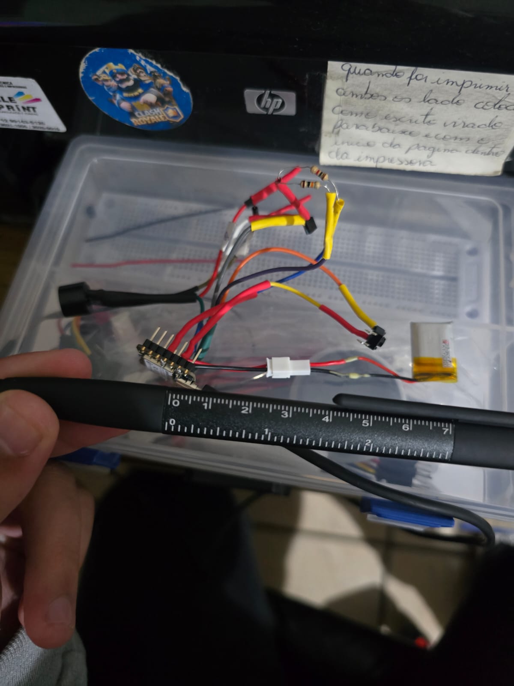
docs/prototipo/fotos/placa_com_regua_4.jpeg
