NicolasVMen/app_tcc/docs/prototipo/fotos/WhatsApp Image 2026-08-04 at 16.58.53.jpeg

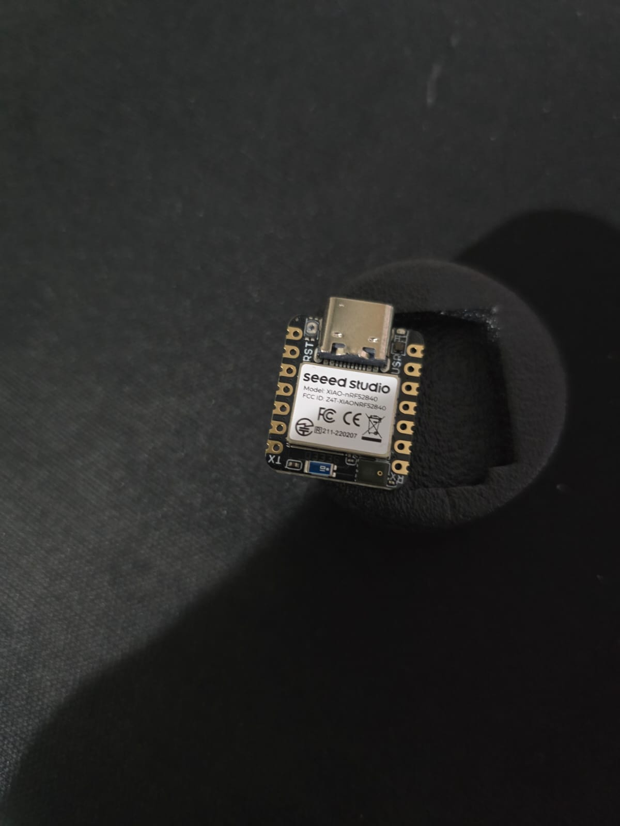
docs/prototipo/fotos/WhatsApp Image 2026-08-04 at 16.58.53.jpeg
