NicolasVMen/app_tcc/docs/prototipo/fotos/WhatsApp Image 2026-08-04 at 21.58.32.jpeg

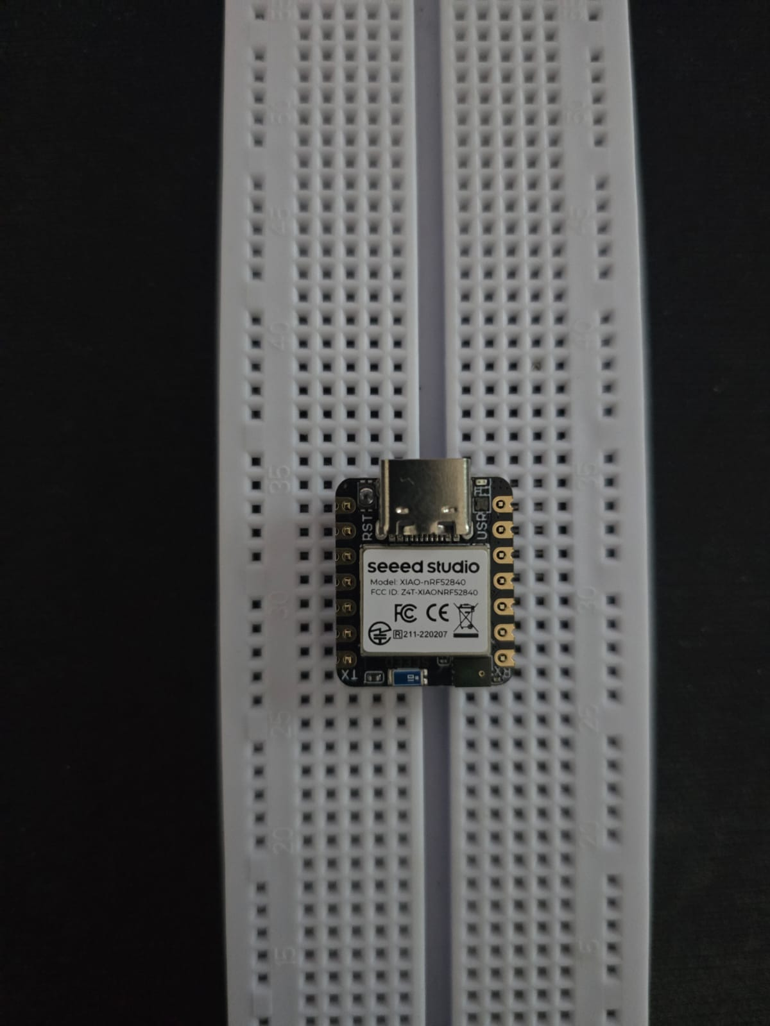
docs/prototipo/fotos/WhatsApp Image 2026-08-04 at 21.58.32.jpeg
