NicolasVMen/app_tcc/docs/prototipo/fotos/WhatsApp Image 2026-08-04 at 22.40.25.jpeg

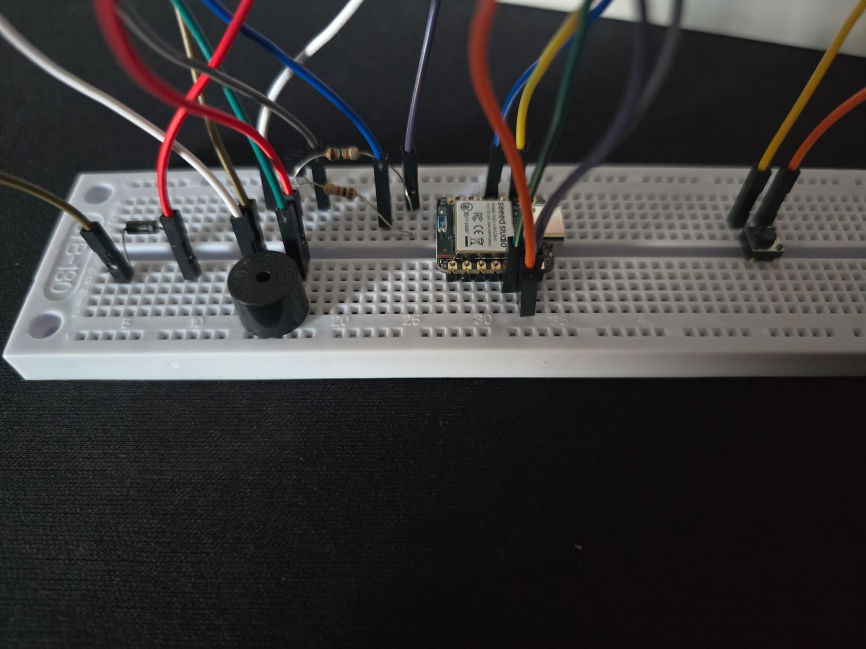
docs/prototipo/fotos/WhatsApp Image 2026-08-04 at 22.40.25.jpeg
