NicolasVMen/app_tcc/docs/prototipo/fotos/WhatsApp Image 2026-08-28 at 17.31.24.jpeg

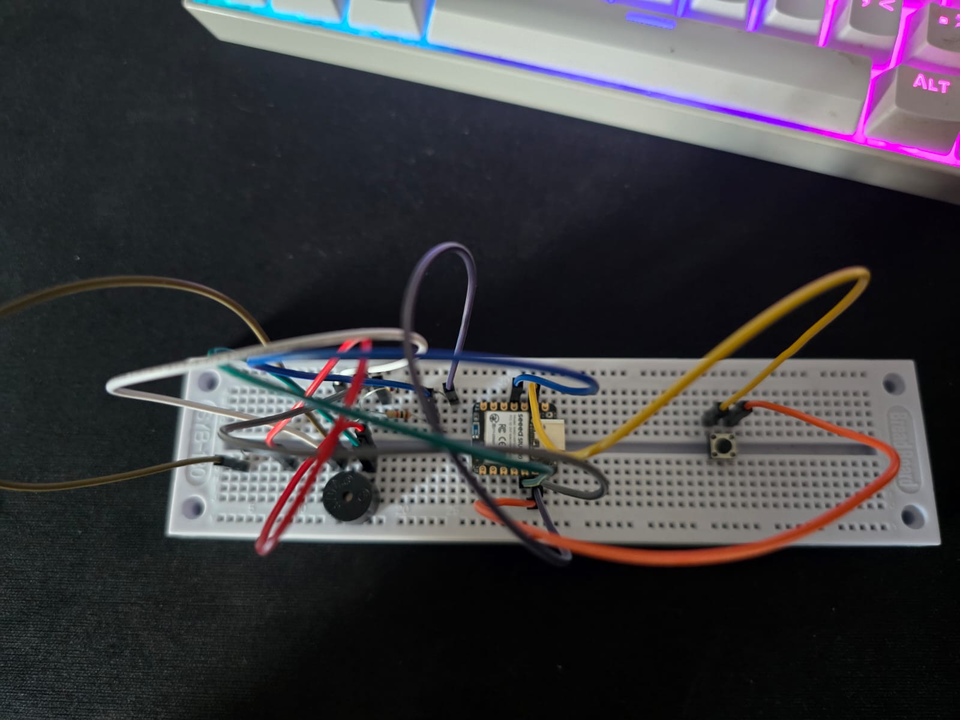
docs/prototipo/fotos/WhatsApp Image 2026-08-28 at 17.31.24.jpeg
