NicolasVMen/app_tcc/docs/prototipo/fotos/WhatsApp Image 2026-09-08 at 16.32.25.jpeg

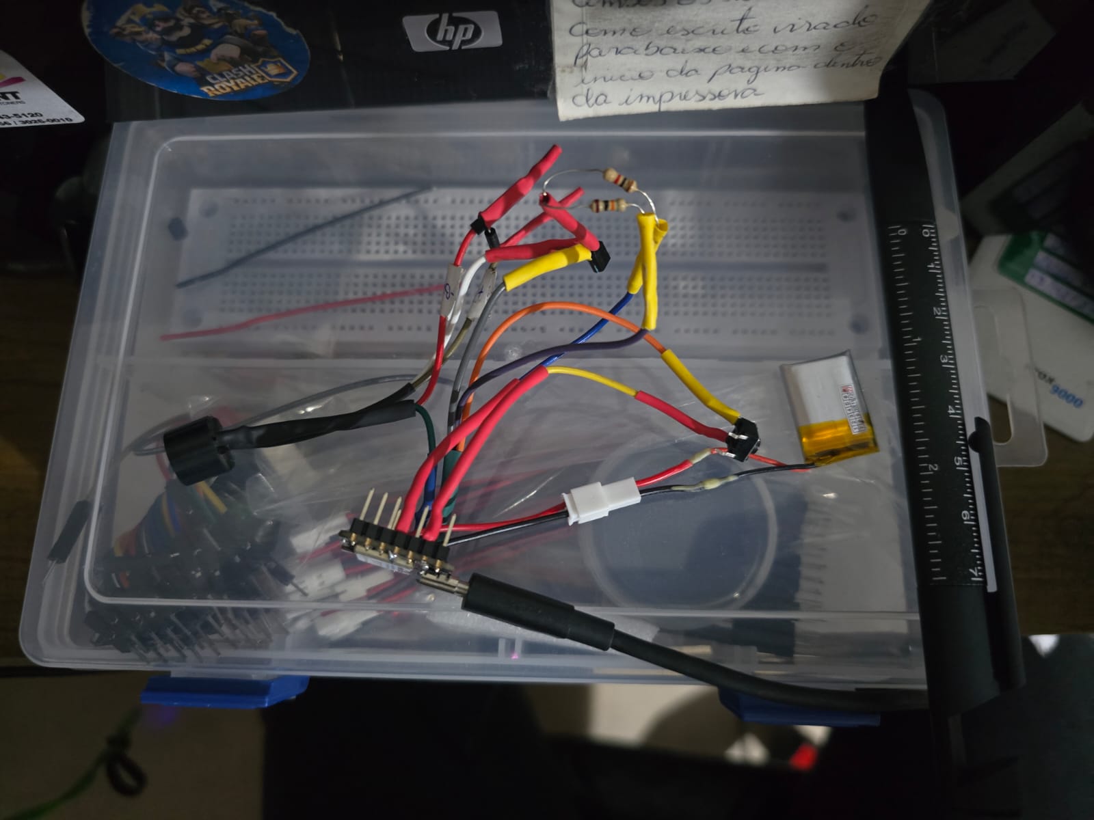
docs/prototipo/fotos/WhatsApp Image 2026-09-08 at 16.32.25.jpeg
