NicolasVMen/app_tcc/docs/prototipo/fotos/WhatsApp Image 2026-09-09 at 18.25.28.jpeg

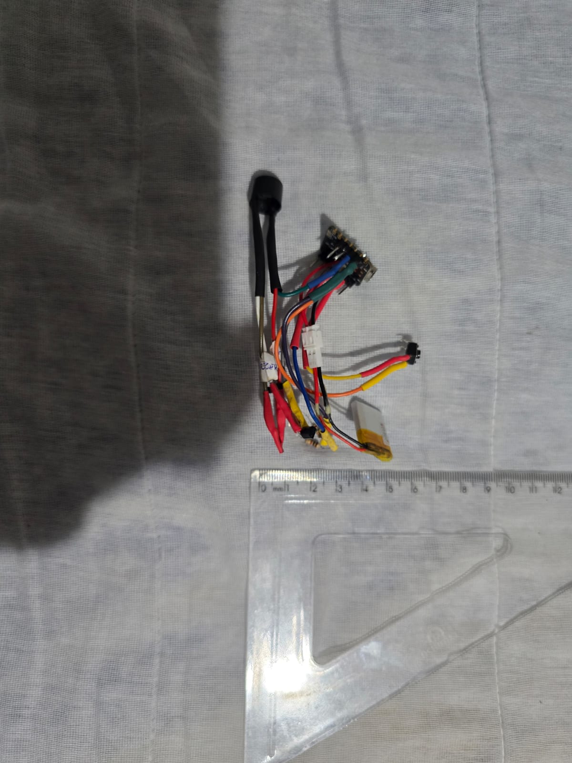
docs/prototipo/fotos/WhatsApp Image 2026-09-09 at 18.25.28.jpeg
