NicolasVMen/app_tcc/docs/prototipo/fotos/WhatsApp Image 2026-09-09 at 18.47.44.jpeg

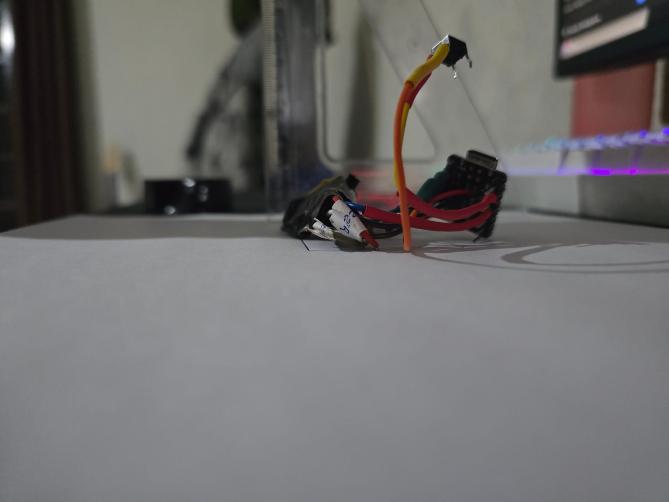
docs/prototipo/fotos/WhatsApp Image 2026-09-09 at 18.47.44.jpeg
