NicolasVMen/app_tcc/docs/prototipo/fotos/WhatsApp Image 2026-09-17 at 21.19.14.jpeg

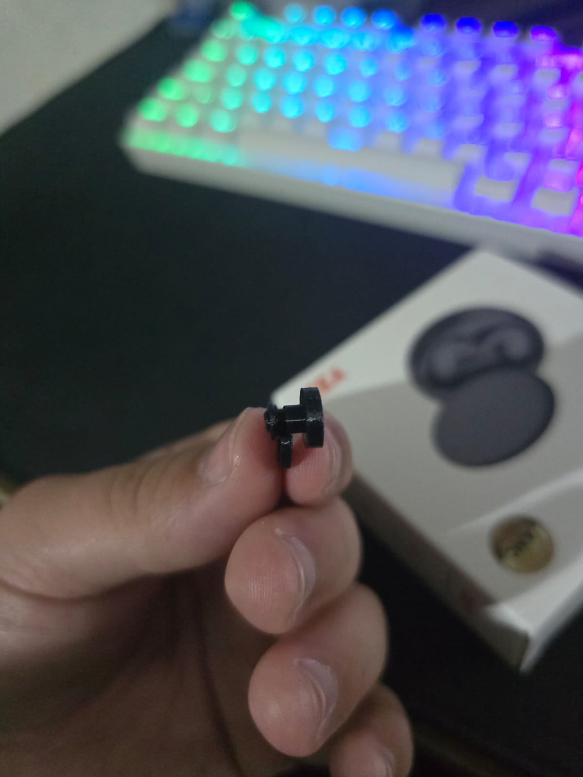
docs/prototipo/fotos/WhatsApp Image 2026-09-17 at 21.19.14.jpeg
