NicolasVMen/app_tcc/docs/prototipo/fotos/WhatsApp Image 2026-09-17 at 21.28.10.jpeg

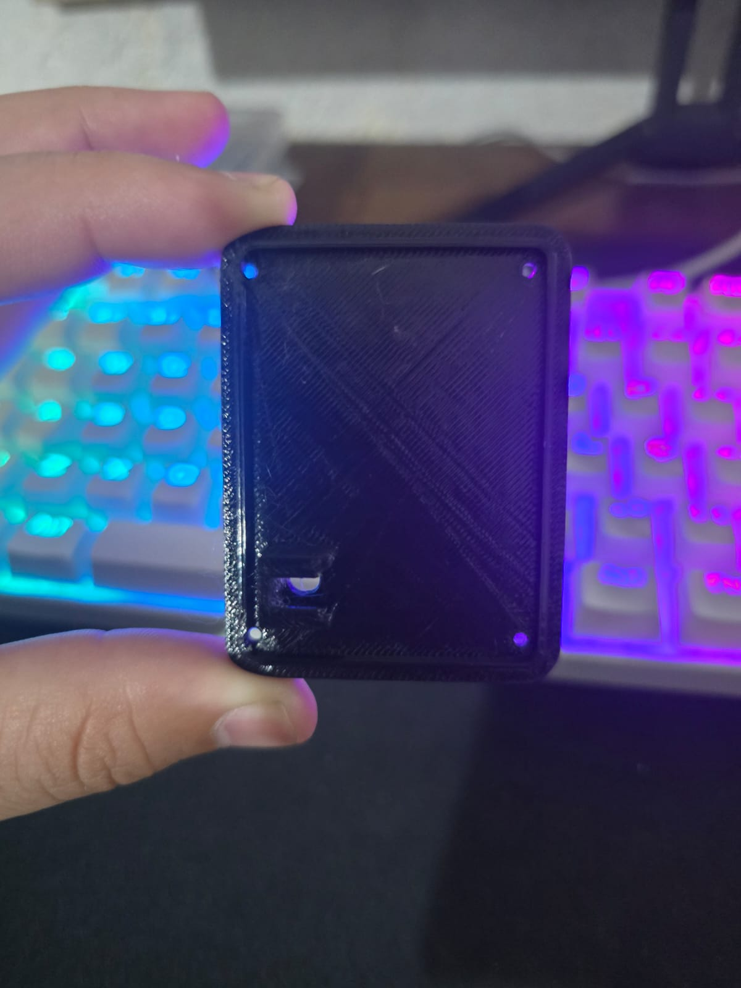
docs/prototipo/fotos/WhatsApp Image 2026-09-17 at 21.28.10.jpeg
