NicolasVMen/app_tcc/docs/prototipo/fotos/WhatsApp Image 2026-09-24 at 16.49.19.jpeg

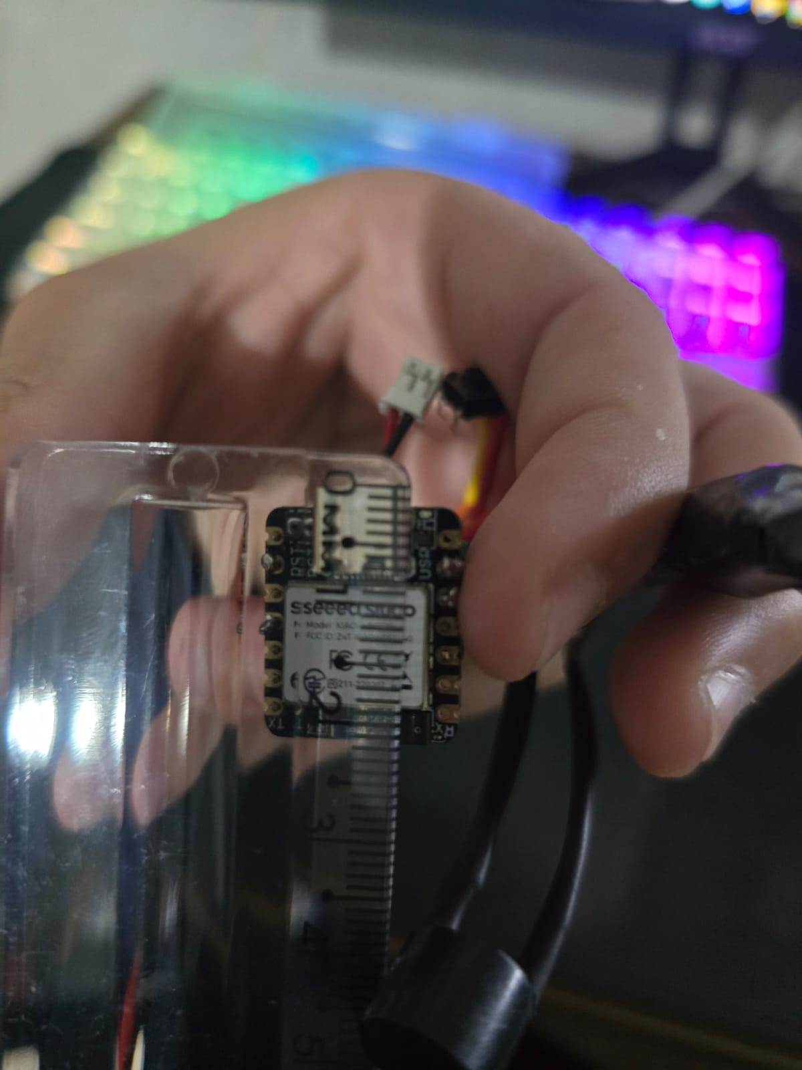
docs/prototipo/fotos/WhatsApp Image 2026-09-24 at 16.49.19.jpeg
