NicolasVMen/app_tcc/hardware/case_3d/PARA_IMPRIMIR_AGORA/01_base_v2_6.stl

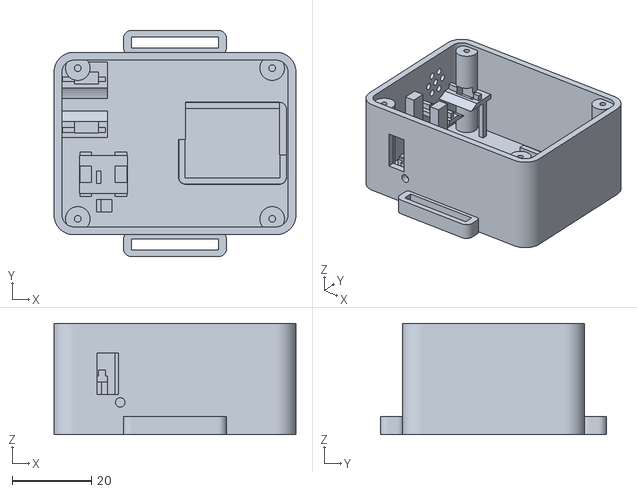
[picture p92: CAD file, 2026-10-17]
hardware/case_3d/PARA_IMPRIMIR_AGORA/01_base_v2_6.stl
61.0 x 57.0 x 28.0
