NicolasVMen/app_tcc/hardware/case_3d/PARA_IMPRIMIR_AGORA/03_botao_vermelho_v2_7.stl

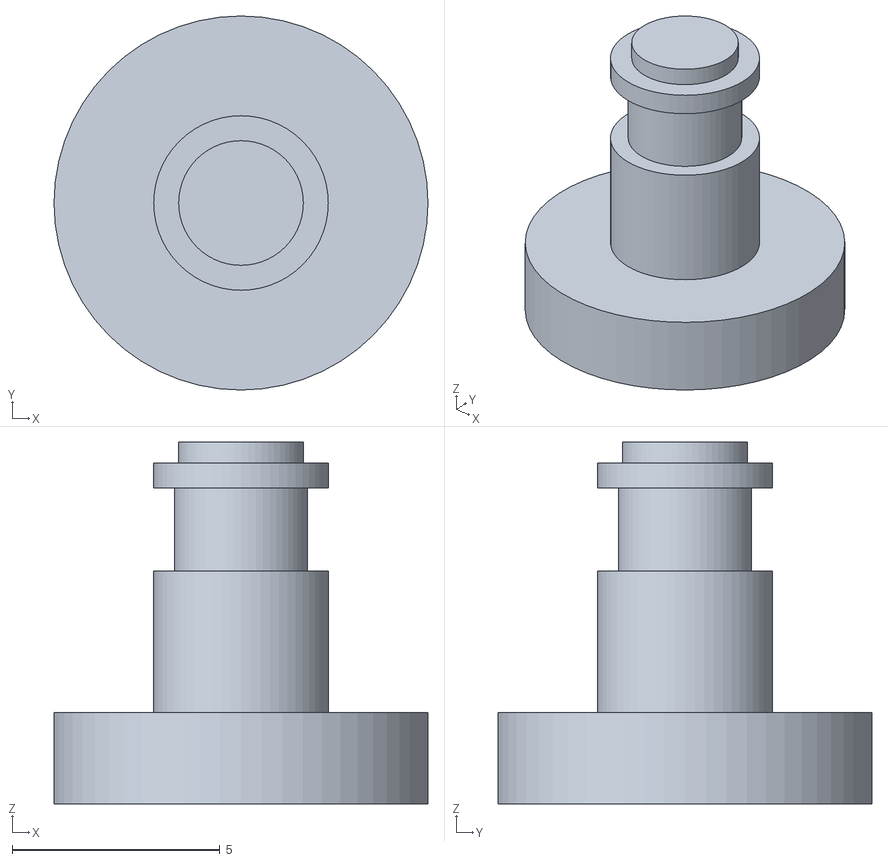
[picture p93: CAD file, 2026-10-17]
hardware/case_3d/PARA_IMPRIMIR_AGORA/03_botao_vermelho_v2_7.stl
9.00 x 9.00 x 8.70
