NicolasVMen/app_tcc/hardware/case_3d/PARA_IMPRIMIR_AGORA/02_tampa_v2_8.stl

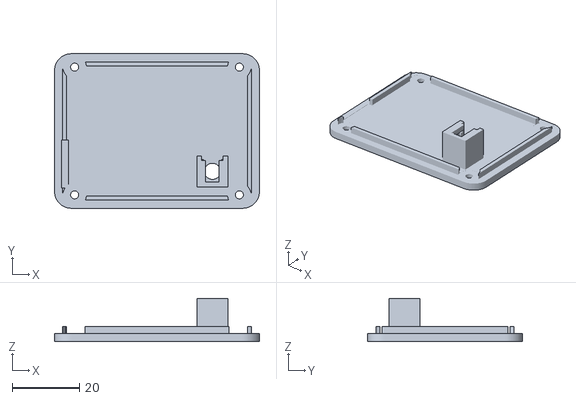
[picture p94: CAD file, 2026-10-17]
hardware/case_3d/PARA_IMPRIMIR_AGORA/02_tampa_v2_8.stl
61.0 x 46.0 x 12.8
