NicolasVMen/app_tcc/hardware/case_3d/PARA_IMPRIMIR_AGORA/04_trava_C_v2_5.stl

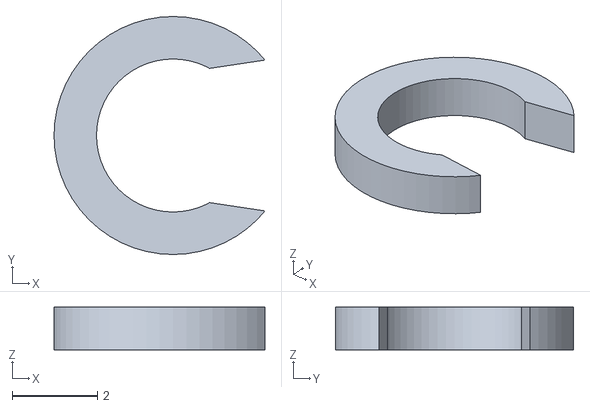
[picture p95: CAD file, 2026-09-25]
hardware/case_3d/PARA_IMPRIMIR_AGORA/04_trava_C_v2_5.stl
4.96 x 5.60 x 1.00
