NicolasVMen/app_tcc/hardware/case_3d/verificacoes/scripts/verificar_stl.scad

// Visualizador dos STL finais. O caminho e substituido pela linha de comando.
arquivo = "escolta_base_v2_2.stl";
import(arquivo, convexity = 10);
