NicolasVMen/app_tcc/hardware/case_3d/verificacoes/scripts/visualizar_passantes.scad

// Revisao de encaixe - item 1, 23/09/2026.
// F5: passantes isolados; laranja = fita nominal 4,8 x 1,5 mm.
// As pecas desta vista sao detalhes, NAO um arquivo para imprimir.
include <escolta_case_v2.scad>
part = "tie_detail";
show_components = false;
