NicolasVMen/app_tcc/hardware/case_3d/documentacao/INSTRUCOES_TESTE_BOTAO_V2_2.md

# Teste dimensional do botão — revisão V2.2

Este pacote é uma prova funcional antes da impressão da caixa inteira. Não
redimensione os STL.

## Imprimir

1. `escolta_tampa_v2_2.stl`
2. `escolta_botao_reforcado_v2_2.stl`
3. `escolta_trava_botao_reforcada_v2_2.stl`

## Configuração recomendada

- Impressora FDM, bico de 0,4 mm.
- Tampa: PLA ou PETG, camada 0,20 mm, 3 paredes, 20% de preenchimento.
- Botão e trava: PETG, camada 0,12 mm, 4 paredes, 100% de preenchimento.
- Escala: 100% nos três eixos; não usar “ajustar à mesa”.
- Suportes: desativados para as três peças.
- Botão e trava já estão orientados com a face plana na mesa.
- Se necessário, usar brim fino somente nas duas peças pequenas e removê-lo
  completamente antes do teste.

## Montagem e aceitação

1. Introduzir a haste do botão vermelho pelo lado externo da tampa.
2. Pelo lado interno, empurrar a trava em C lateralmente até ela encaixar no
   canal estreito. A trava deve permanecer apoiada contra a face interna da
   tampa e não pode atravessar o furo.
3. Instalar o botão eletrônico no alojamento em U.
4. Executar 20 acionamentos completos.

A prova é aprovada apenas se:

- a cabeça retorna sozinha após cada acionamento;
- existe clique tátil em todos os 20 acionamentos;
- a cabeça não raspa nem trava no furo;
- a trava não sai do canal ao puxar moderadamente a cabeça;
- o botão eletrônico não recua nem se solta do alojamento;
- a cabeça possui pequeno movimento livre, próximo de 0,4 mm, sem ficar solta.

Não colar as peças nesta prova. Se qualquer item falhar, registrar foto lateral
e medir com paquímetro o furo da tampa, a haste, o canal e a espessura da trava.
