NicolasVMen/app_tcc/docs/produto/imagens_montagem/01-transistor-resistores.png

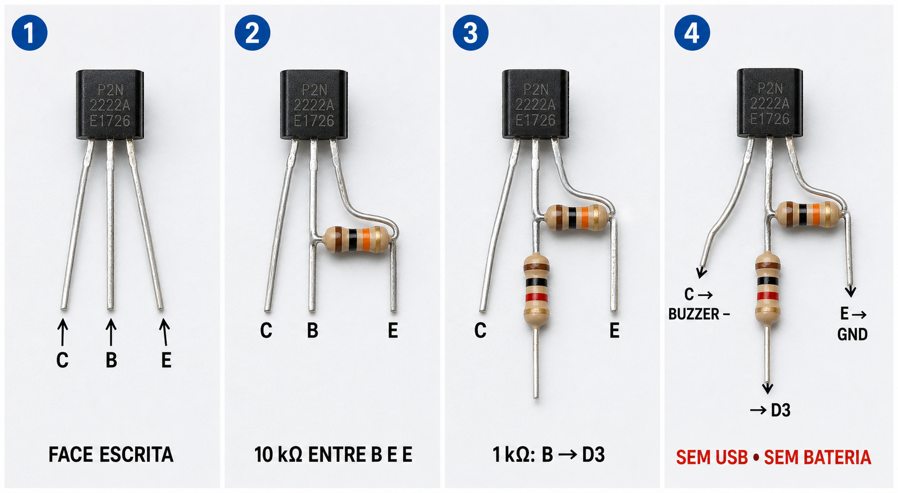
docs/produto/imagens_montagem/01-transistor-resistores.png
