NicolasVMen/app_tcc/docs/produto/imagens_montagem/02-circuito-completo.png

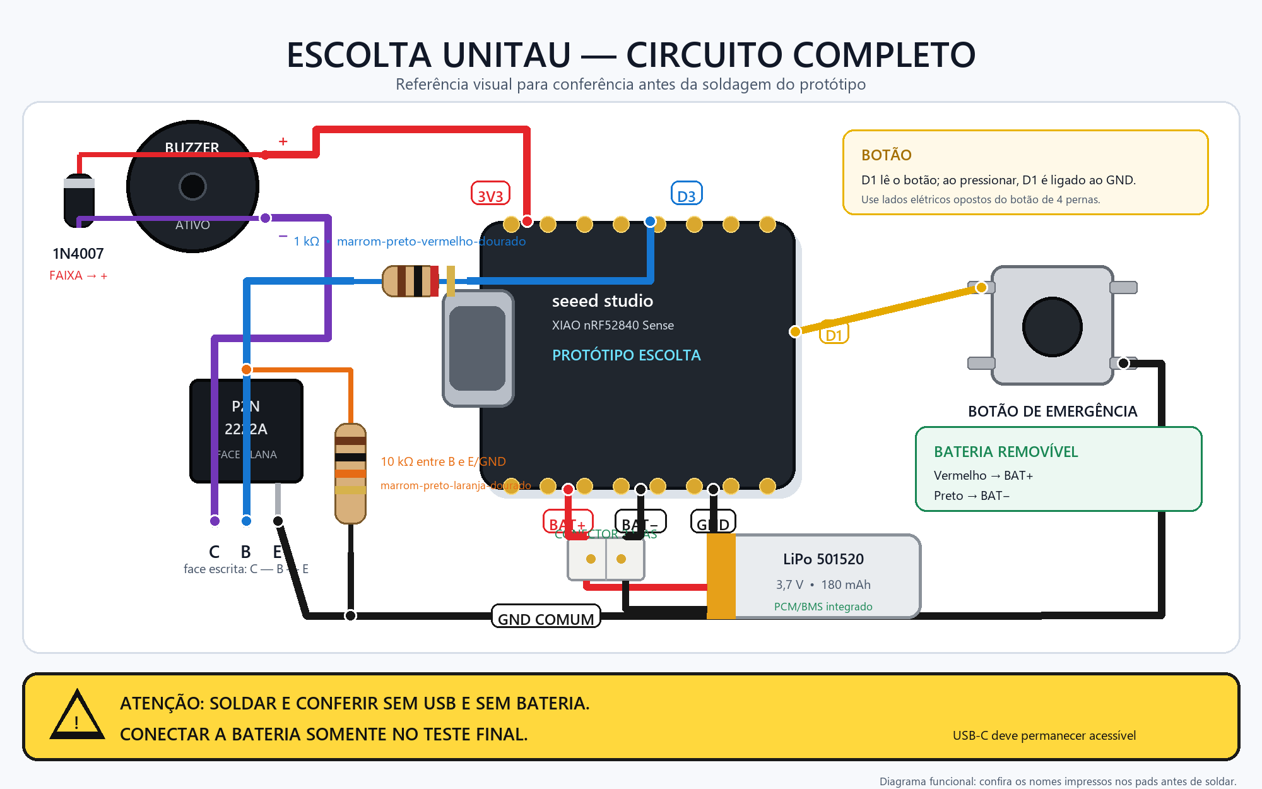
docs/produto/imagens_montagem/02-circuito-completo.png
