NicolasVMen/app_tcc/docs/testes/ANDAMENTO_VALIDACAO_INTERATIVA_2026-10-13.md

# Contagem da validação interativa

## Investigação do retorno ao app em 17/10 — variante ativa diferente

**Resultado posterior no pacote correto:** após espera no antigo e abertura explícita do Teste via USB/Expo, responsável confirmou espera, retomou próximo e confirmou verde. No roteiro Home 30 s/retorno, relatou somente Retomando proteção → verde, sem Procurando. ADB PID 8046 entre 15:52:47.181 e 15:56:27.261: 440 chamadas readRssi, maior intervalo 623 ms, zero eventos de desconexão/reconexão ou erros selecionados na janela. Aprovado esse cenário no Teste por relato e evidência compatível, sem patch de segundo plano. Não aprova oficial antiga nem todos os cenários de processo. Medidas reais/buzzer de 4/5 m K2 continuam válidos como observações; não repetir campanha inteira, mas não atribuir ao pacote Teste as verificações Android feitas na outra instalação.

**Tela bloqueada:** roteiro posterior de 2 min próximo/parado, celular em USB; responsável relatou silêncio, breve Retomando proteção e verde ao voltar. ADB mesmo PID, serviço foreground; 591 chamadas RSSI de 15:56:27.261 a 16:01:23.011, maior intervalo 574 ms, zero eventos selecionados de desconexão/reconexão/erro. Cenário aprovado, sem nova correção. Não comprova autonomia/Doze prolongado/processo morto. Próximo cenário separado é emergência por perda real do enlace com tela bloqueada e confirmação após recuperação, sem botão solto.

**Emergência/recuperação posterior:** responsável recebeu alerta com tela bloqueada após desligar a placa. Confirmação sem placa recusada; Continuar alerta preservou emergência. Ao religar próximo, app encontrou placa e mostrou distância sem apagar emergência; confirmação posterior encerrou e ficou Protegido. ADB PID Teste 8046 registrou desconexão GATT 16:03:21.699 (status 8), reconexão 16:05:14.902 (status 0), leituras até16:05:54 e serviço foreground. Fluxo aprovado por relato/evidência compatível, sem alteração de código. Regres­são curta da variante correta passou; ainda não é APK sem servidor nem promoção. Botão pós-reparo, assinatura/Firebase oficial e validação instalada continuam separados.

Após autorização para investigar, ADB mostrou processo e serviço ativos de **Escolta UNITAU** (`com.nicolasvmen.escoltaunitau`, PID 15668), nenhum processo do pacote `.teste`. Hash do APK instalado coincide com backup oficial antigo `EC9810B0...75D3D35`; manifesto sem `escolta.validated_monitor`, versionName 1.0.0/última atualização 31/07. Teste instalado é 1.0.0-teste, atualizado 15/10. Há desconexões/reconexões em logs, mas sem correlação do ato de minimizar/motivo JS; não chamar causa final. Não se sabe desde quando a sessão usa oficial nem invalidar todos os testes anteriores. Nenhuma alteração de código/radio/app instalado ou reprodução nesta inspeção. Próximo: espera no app atual, abrir especificamente Escolta Teste sem dois monitores concorrentes, confirmar variante e só então reproduzir. Registro: `DIAGNOSTICO_RETORNO_SEGUNDO_PLANO_2026-10-17.md`. Testes 4/5 m da placa K2 permanecem como observações; comportamento do candidato Android ainda não aprovado.

## Retorno K2 — 4/5 m aprovados por relato em 17/10

Após decidir retomar os testes de distância, responsável aprovou o roteiro de 4 m (alvo amarelo sem emergência antecipada) e informou que em 5 m apitou conforme esperado. Mantidos Kalman Q1/R4, amarelo -77/vermelho -90 dBm e confirmação 4 s; nenhuma nova gravação. Sem CSV/RSSI/tempo medido dessa execução e sem confirmação específica de continuidade BLE/ACK após retorno. Não extrapolar como precisão universal nem repetir 1/3 m de K1 como se fossem K2. Pendência de minimizar e voltar (Sincronizando → Procurando), botão após reparo e validação instalada sem servidor seguem separadas. Registro detalhado: `CANDIDATO_KALMAN_K2_2026-10-17.md`.

## Ajuste K2 solicitado em 17/10 — preparação, sem teste físico

Responsável esclareceu que o vermelho indevido a 4 m ocorreu depois de parar e com vínculo normal; pediu voltar emergência a -90 dBm. Autorizou alteração e confirmou espera. K2 opt-in separado mantém Kalman Q1/R4, amarelo -77/-72 e 4 s, altera somente vermelho para -90/-86 e identificação `xiao-p5-r4-d1-k2`; app mantém mesmas guardas K1. 172 testes JS, TypeScript e C++ K1/K2 e perfis anteriores aprovados. Compilação e upload concluídos na XIAO serial `8BDE14575D4B412E`, DFU COM9/retorno COM8, `Device programmed`. Pacote `.expo/proximity-radio4-d1-k2/xiao_escolta_ble.ino.zip`, SHA-256 `F44745314A822F232C76B489C20F6FE33EAC9C2FF8FD75D3B9DB1D01FEEE321E`. Rollbacks K1/D1 preservados. Não foi feito teste físico, retomada, leitura serial ou interação no celular nesta etapa, conforme pedido. Breve sincronização tem caminho previsto; procurar depois não foi diagnosticado como normal nem corrigido. Nenhuma alteração no fluxo de segundo plano. Registro: `CANDIDATO_KALMAN_K2_2026-10-17.md`.

## Candidato K1 gravado em 17/10 — validação física pendente

**Retorno físico posterior:** 1 m aprovado por relato; 3 m respondeu positivamente ao roteiro amarelo/bipe lento; **4 m gerou emergência e reprovou o alvo**. Relato atribui a oscilações enquanto estabiliza, ainda sem CSV/timing nem confirmação de continuidade BLE para estabelecer causa. K1 já usa -85 dBm filtrado/4 s contínuos e mantém emergência retida; não confundir retenção com nova leitura fraca. 5 m ainda não executado nesta rodada. Nenhum novo ajuste/gravação após essa reprovação. Detalhes em `CANDIDATO_KALMAN_K1_2026-10-17.md`.

Após explicar ajuste e limitações, responsável autorizou experimentar K1, confirmou espera/silêncio/USB e reabertura do Escolta Teste em espera. XIAO inicialmente não detectada; reconexão do responsável permitiu confirmar serial `8BDE14575D4B412E`/COM8 e Samsung autorizado. Implementado opt-in `ESCOLTA_TESTE_KALMAN_K1=1`, tag `xiao-p5-r4-d1-k1`, Kalman Q1/R4 escalado pelo intervalo real, limites -77/-85 dBm/4 s. App reconhece tag exata e exige cru/filtrado >-77 para confirmação, sem relaxar frescor/ACK nem alterar variantes antigas. D1, rádio +4, bateria, botão/perda de conexão e padrão oficial preservados.

169 testes JS, TypeScript e asserts ARM (20 K1 mais legado/p3/p4/D1/confirmação) passaram. Programa 335.312 bytes, globais 70.056. Pacote novo `.expo/proximity-radio4-d1-k1/xiao_escolta_ble.ino.zip`, SHA-256 `6E20650F7400448FF776C135598C8F28AA1C072BE672D3E591C4117578659EE9`; rollback D1 íntegro. Upload DFU COM9 concluiu `Device programmed`, retorno COM8. Leitura passiva capturou somente bateria, não tag/radio. **Ainda não aprovado fisicamente, sobretudo 5 m, que continuou verde na simulação**; começar por estabilidade a 1 m e depois 3/4/5 m, sem repetir campanha inteira. Sem geração de APK/promover oficial. Relato pré-K1 de breve sincronização ao voltar do segundo plano tem caminho explicável no código (invalida leitura antiga), mas queda real não foi descartada por logs. Detalhes: `CANDIDATO_KALMAN_K1_2026-10-17.md`.

## Alvo atualizado 3/5 m e simulação em 17/10

Responsável quer amarelo aproximadamente aos 3 m reais e emergência aproximadamente aos 5 m reais, sem alarmes por picos. Comparados offline 11 filtros em 690 amostras/23 séries, com separação cronológica retrospectiva e controles de 1 m. Kalman Q1/R4 com limites comuns -77/-85 teve melhor compromisso exploratório: 1/2 m verdes, 3/4 m amarelos, 7/10 m vermelhos na conferência nova, porém **5 m continuou verde**. Não resolve nem aprova requisito físico. Trocar só limites no filtro atual antecipou vermelho a 4 m e gerou amarelo em um controle de 1 m. Nenhum app/firmware/parâmetro gravado ou modificado; somente análise/documentação. Tempos estacionários e exportação ~1 Hz não validam latência caminhando nem reproduzem exatamente o firmware. Detalhes, resultados desfavoráveis e próxima decisão: `SIMULACAO_ALARMES_3_5M_2026-10-17.md`. Alvo 3/5 m prevalece sobre menções históricas a 2/5 m abaixo; não promover candidato antes de aprovação/validação.

## Conferência D1 recebida em 17/10

Recebido CSV de sete ensaios completos de 1/2/3/4/5/7/10 m, 210 amostras, tag `xiao-p5-r4-d1`; responsável informou ambos parados. IDs/frescor/tempos sem congelamento evidente nas janelas. Erro médio absoluto exportado 1,26190 m. Comparação das duas fórmulas sobre os mesmos RSSIs novos: legada 1,30563 m, D1 1,25253 m (~4,07% de melhora), com piora em 4/7/10 m. Não aprovar precisão de cortes físicos 2/5 m: a 5 m a estimativa ficou 2,4–2,5 m e 27/30 amostras em seguro, com sinal mais forte que em 4 m. Variação/ambiguidade já existia antes de +4, conforme comparação histórica. Não houve reajuste nem gravação nesta análise. Relatório completo: `VALIDACAO_D1_COMPARACAO_HISTORICA_2026-10-17.md`. Não repetir campanha inteira por padrão.

Arquivo atual contém sete ensaios novos apenas; os anteriores estão preservados nos CSVs locais. Não inferir exclusão do app sem esclarecer conta/seleção/histórico. Regressão funcional, botão, bateria, assinatura/Firebase e APK sem servidor continuam pendentes conforme escopo anterior; aprovação de coleta não é aprovação final de precisão.

## Atualização em 15/10 — calibração recebida e correção da exportação

Recebida uma passagem completa de 1 a 10 m (300 amostras novas), com 202 linhas históricas separadas da análise. Responsável dispensou a segunda passagem integral. Inversão entre 4 e 5 m impede prometer limites físicos exatos; oferecida repetição curta de 4/5 m antes de escolher novos coeficientes. Nenhuma fórmula, filtro, potência ou limite de alerta foi alterado. Análise: `ANALISE_CALIBRACAO_RADIO4_1_A_10M_2026-10-15.md`.

Compartilhamento travou com histórico como texto: ADB confirmou `TransactionTooLargeException`, 532.044 bytes ao iniciar o seletor Android. Após confirmação de espera, responsável autorizou corrigir/organizar exportação. Implementados arquivo CSV (URI em vez de texto), escopo completo/último, amostras/resumo, salvar em pasta escolhida, exclusão mútua e erros/cancelamento. Tipagem e 158 testes passaram. APK de desenvolvimento `.teste` compilado, assinatura comparada à anterior, backup do APK de teste preservado e atualização `adb install -r` concluída com `Success`, sem desinstalação/limpeza. Comando de abertura enviado ao Samsung; armazenamento RKStorage permanece presente. Isso não certifica sozinho conteúdo do histórico nem exportação física: confirmar contagem, seletor, cancelamento/repetição, arquivo recebido e vínculo com o responsável. Manual: `EXPORTACAO_ENSAIOS_CSV.md`.

Esta instalação é desenvolvimento com Metro, não APK candidato release/sem servidor e não promoção da oficial. Firmware e pacote oficial não foram alterados. Recuperação BLE após recarga `r` foi obtida pelo responsável desligando/ligando Bluetooth; causa dessa ocorrência não comprovada e não corrigida por este patch de exportação. Pendências de calibração, botão após reparo, bateria e distribuição abaixo continuam abertas.

Na checagem da exportação, responsável relatou rolagem bloqueada no ensaio, inclusive fora dos inputs, já observada antes do novo CSV. Layout nativo mostrou ScrollView com 6.336 px em tela de 2.340 px. Após confirmação de espera, aplicado limite de viewport/área flexível de rolagem e ajustes de gestos/teclado. Tipagem e 159 testes passaram; solicitada reabertura sem `r` para conferir no Samsung. Checagem física de rolagem/exportação continua pendente; ver `CORRECAO_ROLAGEM_ENSAIO_2026-10-15.md`.

Relato posterior: reabrir só a tela não resolveu na sessão antiga; após fechar/abrir o app sem `r`, passou a rolar. ADB confirmou ScrollView do ensaio com 1.930 px, conteúdo 6.478 px e janela 2.340 px: geometria corrigida. Rolagem básica aprovada nessa reabertura, sem comprovar todos os gestos/ciclo de vida. Compartilhamento real do CSV e cancelamento/repetição ainda precisam de confirmação.

CSV posterior recebido: 21 ensaios/584 linhas/22 colunas, preservando as 502 linhas anteriores integralmente, sem duplicatas. Exportação completa por arquivo comprovada uma vez; cancelamento/repetição/resumo/salvar/BLE durante envio ainda não confirmados. Recebidas também as repetições completas de 4 e 5 m: RSSI médio -79,67/-85,83 dBm e estimativas médias 2,72/4,53 m. Primeiro 4 m era -92,03 dBm: variação de 12,37 dB entre ensaios, não um único pico. Sem novos parâmetros ou gravação; detalhes em `ANALISE_REPETICAO_4_5M_E_EXPORTACAO_2026-10-15.md`.

Após explicar os trade-offs, responsável autorizou mudar primeiro somente a distância. Confirmou espera/silêncio/USB e reabertura do app em espera. Variante `xiao-p5-r4-d1` compilada e gravada com sucesso (DFU COM9, retorno COM8), pacote SHA-256 `5C0FE4F16226242BF012FB89EA8C98BC49D433C83EB5534BD2480C352CEA3F28`; rollback anterior preservado. Coeficientes -63,386376 / 3,377961 reproduzidos por ajuste ponderado dos 12 ensaios completos, sem excluir o 4 m desfavorável. Filtros, alarmes -82/-90/4 s, potência e bateria mantidos. 165 testes JS, TypeScript, 33 asserts C++ legados, 11 D1 e perfil p4 passaram. Captura USB após gravação recebeu ADC40/topo4100, sem medir distância/radio na janela. Roteiro independente de 1/2/4/5/10 m e regressão curta ainda não executados. NÃO foram aplicados cortes físicos 2/5 m nem promovida a oficial. Detalhes em `CALIBRACAO_DISTANCIA_RADIO4_D1_2026-10-15.md`.

## Situação consolidada após confirmação visual do topo de bateria

Responsável confirmou: “agora está aparecendo 100%”. Convenção visual de 4,10 V aprovada por relato no app de teste. Isso conclui a conferência visual solicitada, não término físico da carga, capacidade/autonomia ou precisão da faixa baixa. A versão oficial não foi promovida.

Pendências consolidadas, prevalecendo sobre os estados históricos abaixo:

1. Segundo plano por 10 minutos aprovado posteriormente por relato, somente na bateria, sem alertas indevidos; início 95%/4,09 V, fim 90%/4,07 V. A etapa de botão desse roteiro não foi executada: dois fios soltaram e exigem reparo. Emergência foi provocada por afastamento, não substitui o teste físico do botão após conserto. Registro de 10 minutos não demonstra autonomia completa.
2. Bateria real: duração de uso da variante atual e avisos de 20%/10% durante descarga natural. Não simular por mudança da tabela nem exigir descarga profunda. Término de carga permanece não demonstrado; indicação visual de 100% não fecha essa investigação.
3. Rádio/escala: amarelo, vermelho, vínculo mantido, retorno e confirmação aprovados nos roteiros relatados após +4 dBm, com evidência favorável próxima. A estabilidade em uso no corpo e outros ambientes e a exatidão numérica de distância não foram certificadas. Coletas antigas de 3 e 5 m sobrepostas não justificam nova constante arbitrária; não repetir campanha de trena como requisito padrão.
4. Etapa de distribuição: gerar APK de teste independente do Metro quando autorizado, testar abertura sem servidor/internet com sessão previamente autenticada, persistência e fluxos críticos no pacote instalado. Depois revisar diferenças, assinatura, Firebase/certificados/configuração do pacote oficial e promover somente as mudanças aprovadas mediante autorização. Não modificar o oficial nesta consolidação.

Limitações declaradas, não cenários já aprovados: encerramento forçado/morte do processo não têm monitor BLE nativo independente garantido; validação física concentrada no Samsung S24 Ultra. Testes de login, contas, registros, permissões, e-mail e cenários de emergência já aprovados não serão repetidos integralmente por causa do ajuste visual. Esta seção registra pendências, não autoriza novas alterações, geração de APK ou promoção.

Atualização de preparação em 15/10: responsável adiou reparo do botão para segunda-feira e autorizou adiantar melhorias do candidato. Identidade Teste/Oficial separada da ativação das correções, sem promover o padrão oficial. Candidato de teste sem Metro preparado e intermediários de produção validados (bundle, manifesto, Kotlin, Google); suíte 144/144 e TypeScript aprovados. Nenhum APK release gerado/instalado e nenhum firmware gravado. A credencial original foi localizada no EAS e seu certificado corresponde ao APK antigo; não exportadas chaves nem alterado cadastro. Pendências físicas, calibração, autonomia e teste instalado permanecem. Avisos npm (44, zero críticos) triados por alcance, não eliminados. Detalhes/limites/comandos em `docs/auditoria/PREPARACAO_APK_2026-10-15.md`.

Nova direção em 15/10: responsável quer repetir a campanha de 1 até 10 m antes de ajustar distância e seguir aos passos 4–6. Preparado protocolo específico `PROTOCOLO_CALIBRACAO_RADIO4_1_A_10M_2026-10-15.md`, propondo A/B para ajuste/conferência sem modificar o firmware durante a coleta. Nenhuma nova coleta recebida nesta preparação. Reparo/teste do botão permanece condição de aceitação final; não chamar candidato de oficial plenamente validada antes dele. Pulseira informada de 22 mm confrontada com abertura CAD nominal de 22 × 2,8 mm: encaixe não garantido, medir impresso/ponta/espessura antes de comprar. Não alterados código de coleta, CAD, alarmes ou calibração nesta etapa.

## Regressão prioritária em 14/10: remoção de Recentes

O responsável relatou perda do vínculo ao remover o app de Recentes e pediu corrigir antes dos testes de conta. Confirmou Sentinela em espera e silenciosa antes da alteração. Os cenários de minimizar/bloquear já aprovados não comprovam esse outro ciclo de vida.

Foi implementado controlador persistente por conta apenas na versão de teste, sem modificar rádio/firmware ou o ramo oficial. TypeScript aprovado; suíte completa com 117 testes aprovados; bundle Android atualizado servido pelo Metro com HTTP 200. Auditoria: `docs/auditoria/CORRECAO_RECENTES_MONITOR_PERSISTENTE_2026-10-14.md`.

R01 aprovado por relato em 14/10: após o roteiro de recarga em espera, retomada, remoção de Recentes por 30 segundos com dispositivos próximos e reabertura sem busca manual, respondeu “funcionou corretamente”. Não houve captura adicional de logs nessa execução. Isso aprova esse cenário, não morte do processo ou encerramento forçado.

R02 e R03 aprovados por relato em 14/10: respondeu “1 - funcionou / 2 - funcionou” aos roteiros de botão físico com app removido de Recentes, abertura pela notificação e confirmação; e pausa, botão ignorado sem tela, reabertura em espera e retomada. Não foram capturados logs adicionais. A regressão de desmontagem visual passou nos três cenários propostos; os testes de conta podem ser retomados. A contagem original abaixo continua sendo de roteiros da ficha, não inclui R01–R03, e não há aprovação de morte do processo/encerramento forçado.

Base: 24 roteiros M01–M24 e 3 condicionais E01–E03 da ficha essencial. A sequência interativa no chat usa outra numeração; não confundir “teste 8” do chat com M08 da ficha.

Atualização após o responsável relatar menor interferência do braço quando o celular não está apoiado na mesa e pedir concluir os outros testes antes de ajustar rádio. Essa observação não é um ensaio controlado que isola a mesa de orientação/corpo, nem aprovação geral de estabilidade. Potência/PHY/filtro permanecem sem nova alteração.

## Roteiro da ficha com etapa manual ainda necessária: 1

| ID | Parte a concluir |
| --- | --- |
| M01 | Reinício real aprovado por relato em 14/10: respondeu “2 - funcionou” ao reinício em espera, abertura da mesma conta sem novo login, preservação dos dados/espera e retomada a Protegido com Metro disponível. Resta abertura da sessão sem servidor/internet em APK independente; não aprovada pela execução online. |

Resta a etapa offline de M01 com APK independente. M13 foi concluído posteriormente pelo desligamento real da placa, conforme atualização abaixo. Reinício e sessão online já foram aprovados; reconectar ao Metro não aprova abertura offline. Essa contagem de roteiros da ficha não inclui rádio, autonomia ou o tempo adicional de L01. O responsável pediu dois testes por mensagem a partir desta etapa.

## Dois roteiros adiados pelo responsável

- M18: estabilidade perto e falso amarelo em condições com corpo/mesa/orientação.
- M19: validação das transições e escala experimental depois da futura regulagem do rádio. As coletas anteriores ficam preservadas e serão reutilizadas; não solicitar novamente toda a campanha de metragens para preencher ficha.

## Roteiros sem novo teste independente neste passe

- M05: em 14/10 relatou que a conta Google manteve tudo e que a outra conta não recebeu os dados da anterior (“cada um tem a sua”); respondeu “2 - funcionou” ao retorno à conta criada, conferência do marcador TESTE CONTA B, tema diferente, contato com envio desligado e comparação dos registros. Isolamento e persistência aprovados por relato no roteiro proposto, sem captura de telas ou leitura dos dados privados. Não comprova sincronização entre aparelhos, recurso não presente nesse armazenamento local.

- M03: em 14/10 respondeu “funcionou os dois” ao roteiro de criação de conta própria distinta, conferência do nome/e-mail e saída/reentrada com e-mail e senha, sem Google. Aprovado por relato no fluxo real; não houve inspeção das credenciais nem da lista de usuários do Firebase.
- M04: na mesma resposta aprovou envio da recuperação, abertura do link recebido, troca de senha, recusa da antiga e entrada com a nova na conta criada. Aprovado por relato; não se coletam senhas no chat.

- M02: logout, retorno à conta e cancelamento Google relatados funcionando.
- M06: o responsável esclareceu que estava protegido na segunda recusa/revogação. Relatou autorização na primeira tentativa de retomar, recusa posterior com alarme de perda, busca impedida com orientação de permissão, restauração e emergência retida até confirmação. Aprovados os caminhos de recusa/recuperação e continuidade da interface nessa execução por relato. A recusa após proteção ativa não é teste de desarme em espera; não se atribui a essa execução comprovação de silêncio sob revogação em espera.
- M07: respondeu “1 - tudo certo” ao procedimento adicional de recusa de notificação, orientação sem travamento/alarme, permissão restaurada e verificação do aviso de teste. Aprovado nessa execução por relato físico.
- M08: o responsável respondeu “deu certo” ao teste controlado de sirene com cancelamento silencioso e execução com término automático. Aprovado nessa execução por relato. Preferência de vibração desligada/ligada já havia sido testada no contexto de emergência M15; não se presume uma segunda execução silenciosa desse teste controlado.
- M10: respondeu “1 - funcionou certinho” ao procedimento com conexão automática desligada, perda de vínculo, Bluetooth restaurado sem reconectar sozinho, busca manual com leituras, emergência retida até confirmação e preferência automática reativada. Aprovado nessa execução por relato, sem captura de tempos/logs.
- M09: conexão inicial, dados atuais, busca real e recuperação observadas. As situações remanescentes de placa ausente/automático desligado são aproveitadas em M10/M23, não acrescentadas como outra repetição completa.
- M11: botão em primeiro plano, toque curto ignorado, emergência e confirmação. Correção p5 inclui recusa distante e resposta real da placa próxima.
- M12: em 14/10, respondeu “1 - funcionou” ao botão com app minimizado, abertura pela notificação com vínculo/leituras e confirmação posterior. Aprovado por relato. A etapa com tela bloqueada já estava relatada aprovada após a correção de segundo plano; não foi repetida para esta contagem.
- M14: confirmação sem vínculo recusada, emergência mantida, recuperação e confirmação com vínculo.
- M15: vibração desligada/ligada e diferença da notificação de emergência com preferência desligada/ligada relatadas funcionando.
- M16: pausa, permanência em espera ao reabrir, ausência de alarme por botão em espera e retomada relatadas funcionando.
- M17: saída com proteção e reentrada relatadas funcionando. Liberação de recursos no intervalo deslogado não foi medida nessa execução.
- M20: informou 95% estimados e 4,12 V no carregador, funcionamento mantido ao retirar o USB-C e retorno do símbolo de carregamento ao conectar. Declarou “funcionou tudo ok” para o procedimento de USB/bateria. Aprovados continuidade e indicadores nessa execução por relato; não comprova calibração do ADC, capacidade, autonomia nem término real de carga. Relatou nunca observar 100% e sugeriu usar acima de 4,10 V. Nenhum limite foi alterado; revisar indicação/calibração de carga depois do passe funcional, sem substituir arbitrariamente o topo da curva. A escala atual interpola 90% a 4,08 V e 100% a 4,20 V e arredonda para passos de 5%.
- M21: respondeu “2 - tudo ok” ao roteiro de nomes temporários, persistência entre abas, temas, reduzir animações, cancelar/restaurar preferências sem apagar perfil/registros e reposição dos dados originais. Aprovado por relato; não foram capturadas telas ou alterações da conta pela ferramenta.
- M22: o responsável confirmou registros corretos e, após o procedimento de cancelar a prévia e compartilhar em destino próprio, respondeu “certinho, proximo”. Visualização e compartilhamento aprovados nessa execução por relato; não foi apagado histórico para o teste nem capturado o conteúdo pela ferramenta.
- M23: respondeu “tudo certo também” ao roteiro de diagnóstico em espera/ativo, atualização, exportação e abertura/retorno dos ajustes. Aprovado nessa execução por relato, não por inspeção do relatório exportado: o anexo a104671a-0504-4cb2-b656-76b826e071f3 contém novamente o CSV do ensaio 1791943453970-yp27pa, e não o relatório técnico de prontidão. Não se atribui ao anexo comprovação das permissões/estado do diagnóstico.
- M24: respondeu “2 - funcionou também” ao procedimento de interrupção por saída do primeiro plano, interrupção manual com INTERROMPER E GUARDAR e conferência das duas coletas incompletas no CSV. Aprovado por relato; coletas completas e exportação de amostras recentes já haviam sido inspecionadas. Nenhum novo CSV incompleto foi anexado nessa etapa.

Isso não declara todos os subcenários possíveis certificados; registra o que já foi coberto e o que será aproveitado em etapas pendentes.

## Canal de e-mail: roteiros condicionais concluídos por relato

E01 aprovado por relato em 14/10: respondeu “1 - funcionou” ao cancelamento do diálogo sem envio e posterior confirmação com recebimento no endereço próprio, sem alarme ou localização. Não foi inspecionada a mensagem pela ferramenta; não converter esse relato em garantia de entrega futura.

E02 aprovado por relato em 14/10: respondeu “1 - funcionou” ao envio desativado, cancelamento do consentimento de ativação mantendo a opção desligada, emergência pelo botão com saídas locais e confirmação de segurança, sem e-mail dessa emergência recebido na verificação proposta. Não houve inspeção das requisições HTTP; ausência observada nessa execução não é garantia de comportamento de todo provedor futuro.

E03 aprovado por relato em 14/10: respondeu “2 - funcionou” à ativação consentida de envio e compartilhamento, internet/localização ligadas, emergência em primeiro plano, confirmação posterior e conferência do e-mail com link da posição aproximada do celular responsável. Não foram capturados coordenadas, mensagem ou link pela ferramenta. Não aprova precisão geográfica medida, localização da criança, obtenção de GPS em segundo plano nem entrega garantida.

Entrega automática em emergência e falha de internet sem bloquear saídas locais já haviam sido relatadas. Não há fila de reenvio implementada.

## Encerramento desta rodada funcional

Atualização de direção do responsável: pediu terminar os testes e resolver as pendências antes de gerar APK independente. Não preparar/promover APK agora. A rodada de roteiros básicos aprovada não encerra a validação do projeto. Retomar M18/M19 e pendências técnicas sem repetir toda a campanha de trena. Abertura sem Metro permanece etapa final que exige bundle incorporado.

Sequência proposta a partir desse pedido:

1. L01: permanência de pelo menos 10 minutos em segundo plano com tela bloqueada, aparelhos próximos, depois botão físico e retorno com telemetria/confirmacão. Aprovações curtas de R01/R02 não substituem essa duração.
2. M13: tentar perda real pelo afastamento com telefone bloqueado, sem desligar Bluetooth pelo painel, manipular soldas ou exigir nova campanha de metragens. Só aprovar perda se houver evidência de vínculo interrompido; vermelho por RSSI fraco isoladamente não conclui o cenário. Se não houver espaço seguro para interromper, manter pendência explícita.
3. Rádio/M18/M19: diagnosticar configuração efetiva, preservar dados existentes, testar mudanças isoladas e regressões críticas. Não fingir distância real a partir de RSSI nem eliminar amarelo apenas enfraquecendo limiar.
   Atualização: diagnóstico somente leitura capturou 0 dBm de potência da conexão e LE 1M TX/RX. Ensaio separado de +4 dBm foi preparado e gravado após nova confirmação de espera e recarga do app. Após “conectado”, o controlador confirmou escrita/leitura 4 dBm e dois checkpoints mantidos, com PHY/advertising inalterados. Comparação física de bloqueio, transições e escala ainda pendente. Ver `DIAGNOSTICO_RADIO_P5_2026-10-14.md` e `ENSAIO_RADIO_4DBM_2026-10-14.md`; não considerar M18/M19 concluídos pela aplicação da potência.
4. Bateria: verificar indicação de carga/medição antes de alterar topo da curva; ensaio supervisionado de autonomia com duração e condições registradas. Conexão USB aprovada não certifica autonomia ou ADC.
5. Rever cobertura de volume/não perturbe e restrições Android a partir do mapa funcional, sem afirmar que todos os casos possíveis já foram testados. Não forçar encerramento do processo durante proteção só para preencher ficha.

Atualização física: L01 foi executado por 7 minutos, não 10; o responsável informou “mas passou, está ok”. Aprovado por relato para essa duração e roteiro de botão/retorno, sem extrapolar para dez minutos ou autonomia prolongada. A primeira tentativa de M13 atingiu somente amarelo com vínculo mantido, conforme esclarecimento posterior; não foi considerada perda de conexão. O responsável propôs desligar a placa com tela bloqueada e respondeu “1-funcionou” ao roteiro específico de espera pelo alerta, verificação da perda sem distância atual, recusa de confirmação sem placa, religamento/reconexão e confirmação válida. M13 aprovado por relato nessa execução, sem logs adicionais. Não aprova encerramento forçado do processo ou reinício durante emergência.

Resta M01 offline com APK independente. L01 de dez minutos continua com evidência parcial de sete minutos; rádio, bateria e verificações adicionais não estão encerrados.

Após os relatos de E02/E03, não resta roteiro funcional executável desta sequência com a configuração atual, além dos cenários explicitamente adiados/bloqueados acima. Cadastro, recuperação, separação entre contas, reinício com sessão online e a regressão de remoção de Recentes foram acrescentados às aprovações por relato. Isso não é declaração de perfeição, certificação ou aprovação automática para substituir o pacote oficial.

Próxima etapa proposta: APK de teste independente do Metro para abertura offline/sessão e comportamento na distribuição instalada. Preservar o pacote oficial. Permanecem a revisão de rádio/falsos amarelos e escala, indicação de carga/autonomia e restrições do Android; não alterar limites ou firmware apenas para encerrar a ficha.

## Fora dessa contagem

### Atualização radio4 em 14/10 após diagnóstico periódico

Comparação externa atual da bateria recebida: USB conectado e Carregando, app 95%/4,12 V versus multímetro 4,16 V; USB desconectado, app 95%/4,12 V versus multímetro 4,15 V. Diferenças de 30–40 mV, com incerteza do instrumento e estabilização não informadas. Pela curva existente, mesmo 4,15–4,16 V ainda resultariam em 95% exibidos. Não há diagnóstico comprovado de falha do carregador nem motivo para forçar 100%. Ensaio isolado de aquisição ADC mais longa proposto, ainda não executado. Detalhes em `DIAGNOSTICO_INDICACAO_BATERIA_2026-10-14.md`.

Roteiros de restrições de áudio executados posteriormente: (1) zerar volume de mídia, bloquear a tela, segurar botão por 2 s, verificar alerta da caixa/emergência no app, confirmar próximo e restaurar volume; (2) ativar Não Perturbe sem mudar exceções e repetir, confirmar próximo e desativar o modo. Responsável respondeu “funcionou em ambos casos”. Registrar aprovação por relato dos dois roteiros neste Samsung/configuração. Não houve captura da configuração de exceções nem detalhamento separado de som/vibração em cada condição: não afirmar bypass de Não Perturbe, som audível com volume zero ou comportamento universal. Os testes não mudaram áudio, permissões, canais, potência ou firmware. Permanecem indicação de carga/autonomia e abertura offline em APK independente; não promover ao oficial automaticamente.

Leitura de bateria posterior: responsável informou 90%, 4,10 V, somente na bateria. É coerente com a curva implementada: interpolação entre 90% a 4,08 V e 100% a 4,20 V produz aproximadamente 91,67% em 4,10 V, arredondada para 92% e depois exibida em passos de 5% como 90%. Isso verifica cálculo, não a exatidão do ADC nem capacidade/estado real de carga. Mantida pendência de comparar tensão/indicador ao fim do carregamento antes de alterar o topo da curva. Não atribuir 4,10 V a 100% por conveniência.

Nova coleta de 1 m com 30 amostras seguras e estimativa média de 0,89 m (0,8–1,0 m); captura concomitante preservada com 51 consultas reportando +4 dBm e PHY LE 1M, sem queda da potência configurada observada. O responsável confirmou ausência de bipes nesta etapa, amarelo após 12 comprimentos contíguos de pé de aproximadamente 24,5 cm (cerca de 2,94 m), conexão mantida e recuperação automática ao aproximar. Também aprovou o roteiro de vermelho/retorno/confirmação e esclareceu vínculo mantido no vermelho. Aprovação funcional por observação do responsável, não validação da distância numérica no ponto de alerta.

Teste adicional na bateria: após retirar USB, uso normal próximo por 2 minutos e tela bloqueada por mais 1 minuto, respondeu “tudo normal, funcionou conforme esperado”. Aprova essa execução sem falso aviso relatado, não autonomia ou leitura RF na bateria. M18 ganhou evidência favorável nas condições testadas; transições funcionais de M19 aprovadas nesse roteiro, mantendo a limitação da escala experimental e sem certificar outros ambientes. Revisão dos dados antigos mostrou forte sobreposição entre 3 e 5 m; nenhum coeficiente foi alterado, nenhuma nova campanha é solicitada por padrão. Evidência detalhada: `ANALISE_RADIO4_COLETA_PERIODICA_1M_2026-10-14.md`.

Compilação/assinatura/certificado/registro Firebase do pacote oficial, APK independente de Metro, isolamento das mudanças para promoção, testes automatizados e ensaios prolongados de autonomia/restrições Android. São pendências de entrega/técnicas ou campanhas separadas; a contagem da ficha não equivale a aprovação para distribuir a versão final.

Experimento de bateria posterior autorizado após espera/USB: implementado e gravado ADC de 40 µs somente por macro opt-in no p5-r4 de teste, preservando pacote anterior para retorno. Compilação aprovada; suíte 129/129 e quatro novos contratos reconferidos após ajuste da guarda de descoberta Arduino. Carga, percentuais, rádio e regras de alerta não alterados. Seis leituras USB em 30 s mostraram tensão suavizada próxima de 4,127–4,128 V, USB/carga ativos. Sem diagnóstico de rádio nessa janela; não aprova reconexão ou potência runtime. Comparação atual com multímetro, conclusão de carga e autonomia continuam pendentes. Hashes, flags e captura em `DIAGNOSTICO_INDICACAO_BATERIA_2026-10-14.md`.

Comparação externa ADC40 recebida depois: app 95%/4,13 V e multímetro 4,15 V tanto no USB (Carregando) quanto sem USB (sem carregar). Diferença relatada de 20 mV nas duas condições, menor que a comparação inicial; sem calibração/correção arbitrária, sem promoção ao oficial e sem prova causal isolada. Comparação atual recebida, mas término de carga e autonomia seguem pendentes; esclarecer tempo total de carga antes de propor continuação supervisionada.

Responsável estimou duas horas ou mais de carga no dia anterior, sem duração exata, e depois solicitou convenção visual de 100% a partir de 4,10 V. Implementada somente por opt-in na variante de teste, com interpolação 90%/4,08 V, 95%/4,09 V, 100%/4,10 V; toda faixa até 4,08 V e avisos de 20%/10% preservados. Não altera corrente/controle da carga ou tensão informada, não comprova capacidade/carga completa e não elimina pendências de autonomia/fim de carga. Suíte 131/131 aprovada, compilação e gravação concluídas após nova confirmação de espera/USB. Três registros USB confirmaram 100% em aproximadamente 4,13 V, mantendo USB/carga ativos. Visual no app ainda pendente; não promovido ao oficial. Pacote/hash/captura registrados no diagnóstico de bateria.
