NicolasVMen/app_tcc/docs/testes/Ficha_Testes_Escolta.docx

# Escolta — ficha de testes

Plano de 12/10/2026 • 99 casos • resultados para preenchimento manual

Responsável / aparelho / Android: __________________________________________________

Aplicativo / versão / APK / bundle: __________________________________________________

Firmware / energia / configuração da placa: __________________________________________________

Data / ambiente de execução: __________________________________________________

# Antes de começar

- Esta ficha NÃO executa testes e NÃO aprova o aplicativo. Campos de resultado começam vazios. Só o ensaio observado permite preencher Aprovado.
- Sem mudanças adicionais na oficial: testar a versão exata existente primeiro. Firebase e botão Google são as únicas alterações novas autorizadas nesta etapa. Não reinstalar a oficial nem limpar dados para ensaiar.
- A pasta de trabalho contém alterações anteriores fora do Firebase. Não compilar a árvore inteira para substituir a oficial sem auditar a diferença e a assinatura. Um app de desenvolvimento usa o bundle do servidor: trocar esse bundle também muda o código executado.
- O projeto correto é escolta-unitau. Login Google na versão de teste foi relatado como OK pelo usuário, mas não comprova login no pacote/certificado oficial ou todos os demais fluxos. Não marcar automaticamente qualquer caso desta ficha.
- Contas/senhas do Firebase antigo não migram por trocar a configuração. Fazer novo login no projeto atual. Não apagar o projeto anterior ou associar dados de pessoas diferentes.
- Use nomes fictícios e contas/contatos próprios. Não registrar senha, token ou chave privada nas evidências. Não enviar avisos para terceiros sem autorização.
- Somente adultos em teste controlado. Não usar uma criança como sujeito ou depender do protótipo para segurança real. Volume moderado, sem dirigir e sem ligar para números de emergência. Não perfurar, comprimir ou descarregar excessivamente a Li-Po.
- Teste uma instalação de cada vez; não deixe oficial e teste conectados à mesma placa. Sempre restaurar Bluetooth, notificações, energia e preferências ao finalizar.
- Ordem sugerida: identificação → Firebase na candidata → permissões → BLE → botão/perda → segundo plano → proximidade → dados/energia → opcionais → liberação. Após uma falha crítica, registrar e parar aquele fluxo; não modificar o código sem análise.
- Repetição: conexão, botão, perda e confirmação pelo menos 3 vezes por contexto; segundo plano e tela bloqueada separados. Para alarmes, anotar cada saída: caixinha, som do celular, vibração e notificação. Registrar também latência e retorno.
- São cenários de aceitação e regressão, não garantia de perfeição. Algumas expectativas podem revelar defeitos já existentes. Não ajustar o resultado esperado só para transformar falha em aprovação.
- Valores de referência do código atual (confirmar firmware da placa): atenção −78/−73 dBm com 4 s; perigo −86/−82 dBm com 8 s; retorno 2 s; tolerância de perda do app 5 s. Filtragem e detecção do sistema adicionam atraso. Distância estimada por RSSI não é distância garantida.
- Se um recurso não existir naquela versão, preencher Não aplicável e justificar. Se faltar aparelho, internet, bateria ou acesso remoto, preencher Bloqueado. Não tratar Bloqueado ou Não testado como Aprovado.

Resultado: Aprovado / Falhou / Parcial / Bloqueado / Não aplicável / Não testado.
Anotar evidências sem senhas ou tokens. O campo em branco nunca significa aprovação.

# 01 — Identificação e referência

Onde: Oficial atual; repetir na candidata somente para comparar

T001 • Crítico

Como testar: Anotar nome do aplicativo, versão, origem/data do APK, versão do Android, firmware exibido e configuração de alarmes. Fotografar a tela de diagnóstico.

Esperado: A versão ensaiada fica identificada. Sem identificação da build/bundle, o ensaio não aprova uma atualização.

Resultado: __________________ Data/versão: __________________
O que aconteceu: __________________________________________________________
_________________________________________________________________________
Repetições / tempo / evidência: _______________________________________________

T002 • Alto

Como testar: Anotar o que já funciona na oficial, antes de instalar, limpar dados ou mudar configurações. Usar uma única versão por vez.

Esperado: Base de comparação registrada; nenhum arquivo ou dado antigo é apagado.

Resultado: __________________ Data/versão: __________________
O que aconteceu: __________________________________________________________
_________________________________________________________________________
Repetições / tempo / evidência: _______________________________________________

T003 • Alto

Como testar: Abrir e fechar normalmente três vezes, alternando abas sem conectar a caixinha.

Esperado: Sem fechamento inesperado, tela branca persistente ou perda de sessão.

Resultado: __________________ Data/versão: __________________
O que aconteceu: __________________________________________________________
_________________________________________________________________________
Repetições / tempo / evidência: _______________________________________________

T004 • Normal

Como testar: Revisar perfis, preferências e registros existentes; anotar quais devem ser preservados.

Esperado: Dados de referência documentados antes da mudança de Firebase.

Resultado: __________________ Data/versão: __________________
O que aconteceu: __________________________________________________________
_________________________________________________________________________
Repetições / tempo / evidência: _______________________________________________

# 02 — Firebase, Google e contas

Onde: Candidata com Firebase novo; login Google já relatado OK no teste

T005 • Crítico

Como testar: Conferir projeto escolta-unitau, pacote oficial com.nicolasvmen.escoltaunitau e SHA do certificado da build que será instalada. Não confundir com o pacote .teste.

Esperado: Cadastro Android do pacote/certificado correspondente confirmado. Login OK no teste não aprova automaticamente o pacote oficial.

Resultado: __________________ Data/versão: __________________
O que aconteceu: __________________________________________________________
_________________________________________________________________________
Repetições / tempo / evidência: _______________________________________________

T006 • Alto

Como testar: Sair e abrir Continuar com Google; cancelar sem escolher conta.

Esperado: Permanece no login, sem conta criada por cancelamento, sem erro fatal; botão volta a responder.

Resultado: __________________ Data/versão: __________________
O que aconteceu: __________________________________________________________
_________________________________________________________________________
Repetições / tempo / evidência: _______________________________________________

T007 • Crítico

Como testar: Entrar com a conta Google usada no teste; verificar nome/e-mail e o usuário no Firebase do projeto correto.

Esperado: Acesso somente após autenticação válida; conta correta, sem senha/token expostos em mensagens.

Resultado: __________________ Data/versão: __________________
O que aconteceu: __________________________________________________________
_________________________________________________________________________
Repetições / tempo / evidência: _______________________________________________

T008 • Alto

Como testar: Tocar várias vezes no botão Google enquanto o seletor está abrindo.

Esperado: Um único fluxo de login, sem seletores ou acessos duplicados.

Resultado: __________________ Data/versão: __________________
O que aconteceu: __________________________________________________________
_________________________________________________________________________
Repetições / tempo / evidência: _______________________________________________

T009 • Alto

Como testar: Desligar internet, tentar Google; restaurar internet e tentar novamente.

Esperado: Falha compreensível sem acesso inventado; nova tentativa funciona, sem botão preso carregando.

Resultado: __________________ Data/versão: __________________
O que aconteceu: __________________________________________________________
_________________________________________________________________________
Repetições / tempo / evidência: _______________________________________________

T010 • Crítico

Como testar: Fechar/reabrir e reiniciar o celular após login; testar também abertura sem internet com sessão já salva.

Esperado: Sessão válida persiste. Sem internet, monitoramento BLE não depende de login online a cada abertura; restrições são claras.

Resultado: __________________ Data/versão: __________________
O que aconteceu: __________________________________________________________
_________________________________________________________________________
Repetições / tempo / evidência: _______________________________________________

T011 • Crítico

Como testar: Sair da conta com a caixinha desligada; reabrir e entrar novamente.

Esperado: Volta ao login, sem acesso ao perfil anterior após logout; novo login funciona.

Resultado: __________________ Data/versão: __________________
O que aconteceu: __________________________________________________________
_________________________________________________________________________
Repetições / tempo / evidência: _______________________________________________

T012 • Crítico

Como testar: Usar duas contas próprias A/B com nomes fictícios e preferências distintas. Alternar A → B → A.

Esperado: Perfis, históricos, contatos, ensaios e preferências não se misturam; A recupera somente seus dados.

Resultado: __________________ Data/versão: __________________
O que aconteceu: __________________________________________________________
_________________________________________________________________________
Repetições / tempo / evidência: _______________________________________________

T013 • Alto

Como testar: Editar o nome do perfil; sair/entrar por Google novamente.

Esperado: Login não sobrescreve automaticamente um nome já editado no aplicativo.

Resultado: __________________ Data/versão: __________________
O que aconteceu: __________________________________________________________
_________________________________________________________________________
Repetições / tempo / evidência: _______________________________________________

T014 • Alto

Como testar: Cadastro por e-mail: testar nome vazio, e-mail inválido, senha curta e confirmação diferente.

Esperado: Não cria conta inválida; apresenta orientação e libera correção dos campos.

Resultado: __________________ Data/versão: __________________
O que aconteceu: __________________________________________________________
_________________________________________________________________________
Repetições / tempo / evidência: _______________________________________________

T015 • Alto

Como testar: Cadastrar um e-mail próprio novo com dados válidos; sair e entrar por e-mail/senha.

Esperado: Conta criada uma vez e acesso válido no projeto correto; perfil pode ser completado.

Resultado: __________________ Data/versão: __________________
O que aconteceu: __________________________________________________________
_________________________________________________________________________
Repetições / tempo / evidência: _______________________________________________

T016 • Alto

Como testar: Tentar cadastrar novamente o mesmo e-mail; tentar login com senha incorreta.

Esperado: Não duplica a conta nem permite acesso; erro legível sem travar.

Resultado: __________________ Data/versão: __________________
O que aconteceu: __________________________________________________________
_________________________________________________________________________
Repetições / tempo / evidência: _______________________________________________

T017 • Alto

Como testar: Solicitar recuperação de senha da conta e-mail/senha; cancelar primeiro e depois confirmar.

Esperado: Cancelar não envia; confirmar fornece instrução genérica. Verificar chegada e spam; link válido permite redefinir senha.

Resultado: __________________ Data/versão: __________________
O que aconteceu: __________________________________________________________
_________________________________________________________________________
Repetições / tempo / evidência: _______________________________________________

T018 • Crítico

Como testar: Após redefinir senha, testar a senha antiga e a nova.

Esperado: Senha antiga rejeitada; nova permite acesso. Não aplicar este caso à conta exclusivamente Google.

Resultado: __________________ Data/versão: __________________
O que aconteceu: __________________________________________________________
_________________________________________________________________________
Repetições / tempo / evidência: _______________________________________________

T019 • Normal

Como testar: Recuperação com e-mail inexistente; conta Google sem senha; formulário vazio.

Esperado: Sem erro fatal e sem revelar quais contas existem. Não prometer recuperação por senha para conta exclusivamente Google.

Resultado: __________________ Data/versão: __________________
O que aconteceu: __________________________________________________________
_________________________________________________________________________
Repetições / tempo / evidência: _______________________________________________

T020 • Alto

Como testar: Conta Google e e-mail/senha com o mesmo endereço: se surgir conflito, registrar a mensagem; não criar vínculo por conta própria.

Esperado: Sem união silenciosa ou exposição de dados entre contas. Conflito recebe orientação; eventual vinculação exige autenticação e revisão separada.

Resultado: __________________ Data/versão: __________________
O que aconteceu: __________________________________________________________
_________________________________________________________________________
Repetições / tempo / evidência: _______________________________________________

T021 • Crítico

Como testar: Primeira abertura oficial com Firebase novo e dados locais antigos. Conferir sessão e registros, sem limpar armazenamento.

Esperado: Pede autenticação do novo projeto; não reutiliza token antigo nem atribui perfil antigo a outra pessoa. Usuários/senhas de outro projeto não são transferidos automaticamente.

Resultado: __________________ Data/versão: __________________
O que aconteceu: __________________________________________________________
_________________________________________________________________________
Repetições / tempo / evidência: _______________________________________________

T022 • Normal

Como testar: Revisar botão Google nos temas claro/escuro e com fonte aumentada; tocar símbolo e texto.

Esperado: G colorido legível, proporções preservadas, texto sem corte e toda a área funcional; durante solicitação não aceita duplicação.

Resultado: __________________ Data/versão: __________________
O que aconteceu: __________________________________________________________
_________________________________________________________________________
Repetições / tempo / evidência: _______________________________________________

# 03 — Permissões e notificações

Onde: Oficial atual; repetir na candidata somente para comparar

T023 • Crítico

Como testar: Sem monitoramento ativo, retirar Dispositivos próximos e reabrir. Se pedir autorização, negar. Aguardar 30 s.

Esperado: App permanece utilizável, sem ciclo de fechamento e sem alegar proteção. O Android pode encerrar o processo ao revogar permissão; avaliar a reabertura.

Resultado: __________________ Data/versão: __________________
O que aconteceu: __________________________________________________________
_________________________________________________________________________
Repetições / tempo / evidência: _______________________________________________

T024 • Crítico

Como testar: Após recusa, permitir Dispositivos próximos nas configurações e voltar.

Esperado: Reconexão fica disponível sem limpar dados ou reinstalar; sem pedidos repetidos a cada tentativa automática.

Resultado: __________________ Data/versão: __________________
O que aconteceu: __________________________________________________________
_________________________________________________________________________
Repetições / tempo / evidência: _______________________________________________

T025 • Alto

Como testar: Negar notificações, abrir e conectar BLE com Bluetooth autorizado.

Esperado: App não fecha. Informa que avisos do sistema estão bloqueados; negar notificação não deve desligar a sirene crítica interna.

Resultado: __________________ Data/versão: __________________
O que aconteceu: __________________________________________________________
_________________________________________________________________________
Repetições / tempo / evidência: _______________________________________________

T026 • Alto

Como testar: Permitir notificações; usar Verificar prontidão → Testar notificação, quando disponível.

Esperado: Aviso aparece na central de notificações, sem emergência falsa ou fechamento. Banner depende das configurações do Android.

Resultado: __________________ Data/versão: __________________
O que aconteceu: __________________________________________________________
_________________________________________________________________________
Repetições / tempo / evidência: _______________________________________________

T027 • Alto

Como testar: Tocar a notificação de monitoramento e depois a de alerta.

Esperado: Abre a própria versão correta e a Central, não outro Escolta instalado.

Resultado: __________________ Data/versão: __________________
O que aconteceu: __________________________________________________________
_________________________________________________________________________
Repetições / tempo / evidência: _______________________________________________

T028 • Alto

Como testar: Remover só a permissão de localização; não desativar o Bluetooth.

Esperado: No Android 12+, BLE com scan/connect continua disponível. Localização opcional não deve bloquear BLE. Android antigo pode precisar de localização para descoberta.

Resultado: __________________ Data/versão: __________________
O que aconteceu: __________________________________________________________
_________________________________________________________________________
Repetições / tempo / evidência: _______________________________________________

T029 • Alto

Como testar: Negar localização ao ativar compartilhamento de localização.

Esperado: Sem fechamento; indica indisponibilidade e não inventa coordenadas. Não envia localização sem autorização.

Resultado: __________________ Data/versão: __________________
O que aconteceu: __________________________________________________________
_________________________________________________________________________
Repetições / tempo / evidência: _______________________________________________

T030 • Alto

Como testar: Durante ensaio supervisionado, retirar Bluetooth ou notificações, depois reabrir e restaurar.

Esperado: Sem proteção falsa nem travamento; perda do enlace registrada quando detectável. Revogação pode encerrar processo pelo sistema e precisa ser documentada.

Resultado: __________________ Data/versão: __________________
O que aconteceu: __________________________________________________________
_________________________________________________________________________
Repetições / tempo / evidência: _______________________________________________
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
