NicolasVMen/app_tcc/docs/testes/Ficha_Testes_Escolta_ESSENCIAL.docx

# Escolta — testes essenciais

13/10/2026 • 24 roteiros de integração + 3 condicionais de e-mail/localização

App/versão/bundle: __________________________________________________

Android/modelo: __________________________________________________

Firmware/alimentação: __________________________________________________

Data/responsável: __________________________________________________

# Leia antes de testar

- USE ESTA FICHA ENXUTA no próximo passe. Substitui os 99 casos anteriores; arquivos/anotações antigos foram preservados. Resultados começam vazios e não significam aprovação.
- 24 roteiros de integração + 3 de e-mail/localização somente se usar esses recursos. Não repetir login Google básico já confirmado na mesma build. Logout/reentrada e novo pacote/certificado são situações diferentes.
- A fonte atual monta Central, Protocolo, Registros, Sistema, diagnóstico e Ensaio de proximidade. Se um desses controles não existir no APK executado, pare e informe nome/versão/print: não invente função nem instale outra versão só para preencher.
- Eu executei 85 testes automatizados e 33 verificações C++: regras locais, fórmulas, UUIDs, parser, contagem/CSV e controle de callbacks saíram da lista humana. Isso não prova integração real com rádio, SDKs, armazenamento do Android, som ou serviços externos.
- Cada roteiro explica POR QUE ainda é manual e QUAL caminho tela→serviço/placa verifica. Siga preparação e passos, registre esperado versus observado e restaure antes do próximo.
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
