NicolasVMen/app_tcc/(commit log)

2026-03-30 Atualiza monitor ESP32 e adiciona alerta sonoro
2026-07-13 Melhora localizacao: filtragem de RSSI no ESP32 + preparo p/ GPS
    Firmware (codigo_c.txt / esp32_escolta):
    - Filtro EMA no RSSI para suavizar ruido do Wi-Fi
    - Histerese nos limiares (entra != sai) evitando tremular de estado
    - Debounce: so alarma apos N leituras ruins seguidas (fim dos falsos alarmes)
    - Panico exige sinal ruim/desconexao sustentados
    - Buzzer nao-bloqueante (remove delay() que travava o servidor)
    - Distancia estimada (modelo log-distance) exposta no /api/status e na pagina
    - Estrutura de GPS (NEO-6M) ja preparada via #define USAR_GPS
    App:
    - API e hook passam a confiar no estado filtrado da placa (estado/distancia)
    - Dashboard mostra distancia estimada
    - Corrige caminho do aud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
2026-07-15 Backup antes da migracao Wi-Fi para BLE
2026-07-15 fix: pin expo-font to SDK 54 compatible version
2026-07-22 feat: Versao Final APK com Correcoes de UI e Autenticacao
2026-07-24 Refatoração e Limpeza: Adição de GPS, nova documentação e organização de arquivos acadêmicos
2026-08-01 feat: adiciona modo de espera seguro
2026-08-03 feat: adiciona verificacao de prontidao
2026-09-09 feat: adiciona telemetria de bateria e registra avanços do protótipo
2026-09-25 feat: organiza repositorio e atualiza prototipo vestivel
    [01_base_v2_4.stl, 02_tampa_v2_4.stl, 03_trava_C_v2_4.stl, botao_prolongador_v2_4_reutilizavel.stl, conferir_bateria_fixa.scad, escolta_case_v2.scad, verificar_stl.scad, visualizar_botao.scad]
2026-10-17 feat: consolida oficial 1.0.1, firmware e documentacao do Escolta
    Registra monitoramento persistente, autenticacao Google, calibracao e watchdog W1, ferramentas internas isoladas e validacao standalone. Atualiza caixa 3D, ensaios e materiais CICTED. Preserva pendencias do botao fisico e bateria; exclui credenciais, backups e artefatos locais.
    [01_base_v2_4.stl, 01_base_v2_6.stl, 02_tampa_v2_4.stl, 02_tampa_v2_8.stl, 03_botao_vermelho_v2_7.stl, 04_trava_C_v2_5.stl, Escolta_2026-10-15_23-24-03-581_historico_amostras.csv, Escolta_2026-10-17_14-50-10-790_historico_amostras.csv]
2026-11-05 docs: atualiza TCC, resultados e protocolo de autonomia
2026-11-05 feat: adiciona coletor passivo de autonomia opt-in A1
2026-11-05 build: prepara candidata 1.0.2 para coleta de autonomia A1
2026-11-05 docs: registra backup e compilacao da candidata de autonomia 1.0.2
